Mattiplex/RAINBOW-DASH-Keyboard-/README.md

# RAINBOW-DASH-KEYBOARD-
A MLP theme KEYBOARD !!!

oh yeah , watch me take on this four day challenge to create this keyboard with no experience. (editing matthew here) so keeb got extended but i miss the deadline so im shipping to STARDANCE. oh well stardance has ended also well better luck at fabricate !!!

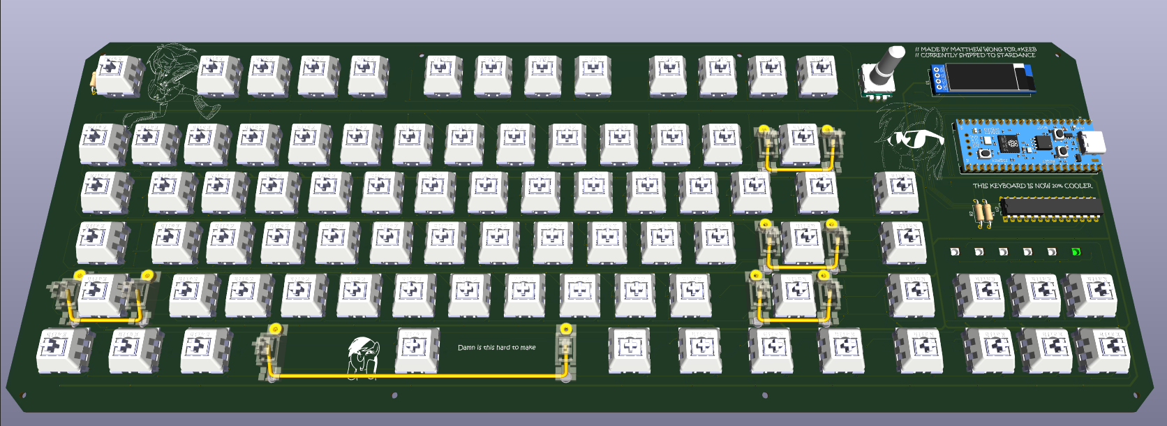
[picture p1: photo folder unlabel/Screenshot 2026-10-20 165513.png]


# The What,Why and What i learn.  
## The WHAT
RAINBOW DASH KEYBOARD is a 75% and TKL Hybrid MLP theme keyboard. this keyboard features 84 mechanical switches with hot swappable socket ,Backlit south facing RGB LED,Rotary Encoder and a 0.91 inch OLED screen.this keyboard is power by 3rd party Pico clone board with usb-c port. i also design a custom Case that uses a bottom mount system, The case will be 3d printed with FDM technology Using PETG and be painted later using spray paint. The plate will be fabricated using aluminum 6061-T6 Alloy and have an anodized blue and glass bead sanding finish.There's also a custom Knob that will be printed using PLA.

## The WHY   
so this is my first keyboard, so i decide to challenge myself to create something that's distinctly me. something that other people doesn't have and that is functional so a keyboard is fun little challenge.i want to be able look at me keyboard and be reminded of the countless night i spend making this keyboard.  

## What have i LEARN ?  
i learn lots of stuff, first of all is to do tons of research before going through something you're not familiar with. i also how to make a keyboard , how to plan your keyboard before hand so you don't mess up later in your PCB phase. (i learn all of these the hard way).
CAD is a bit harder for me because im such a perfectionist. but everything gets better with the flow of time as you gain experience. now the KEYWORD here is failing. during the whole length of this project , i fail a lot and that's how i learn ,you learn by failing and trying again.

# The PCB 

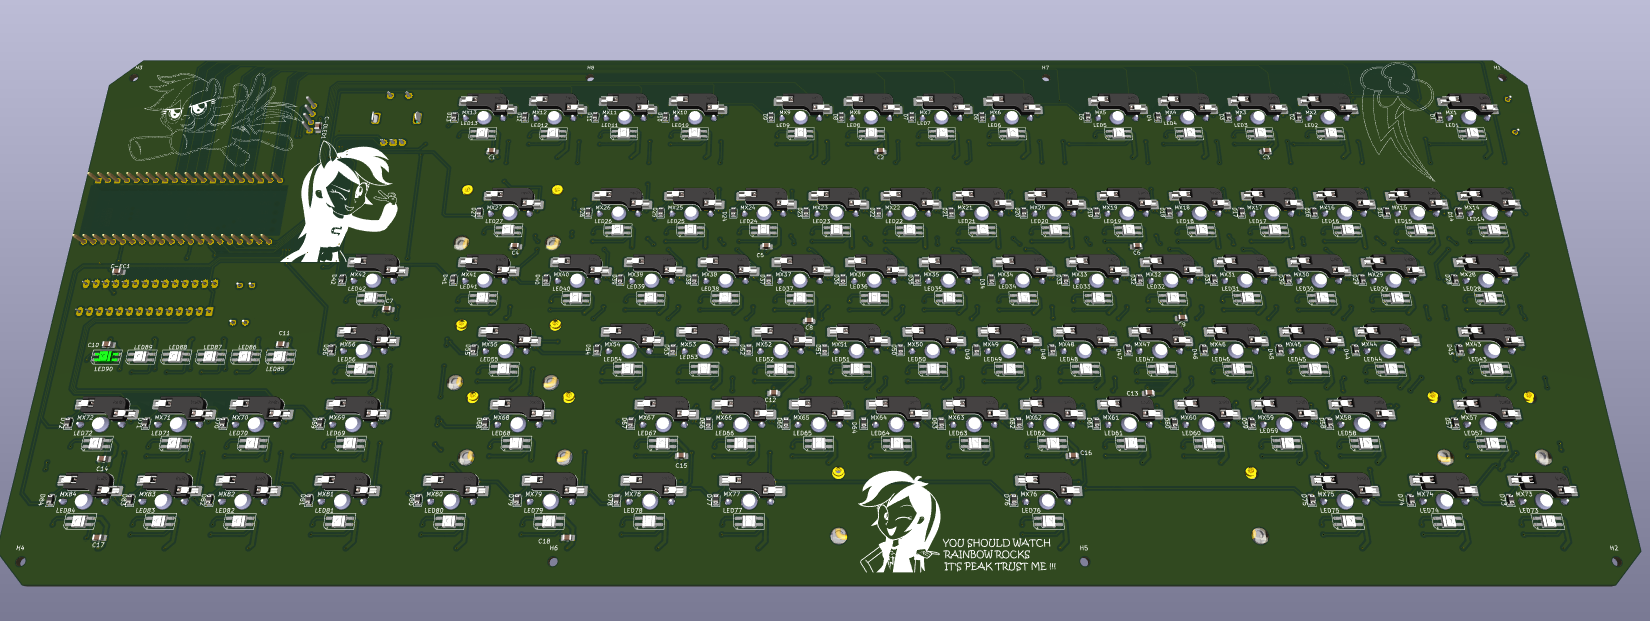
[picture p2: photo folder unlabel/Screenshot 2026-10-20 165417.png]
 

# The Case 

i used Bottom style mount to house my pcb , since i think it's the most balance layout between sound , cost and complexity . i also made the plate to integrate inside the bottom case so the plate would sit flush in the case. 
* Bottom Case: PLA WHITE
* TOP Case : PLA WHITE
* KEYBOARD PLATE : Laser Cut Aluminum (anodized blue + bead blast)
* CUSTOM Knob : PLA WHITE

# README
3D PRINTING : PRINTING LEGION @raahicheda4 (SG)

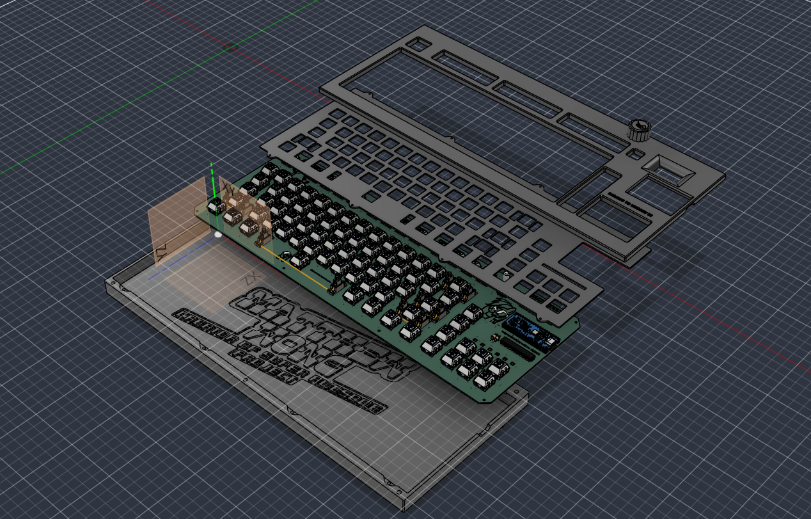
[picture p3: photo folder unlabel/Screenshot 2026-10-20 002253.png]
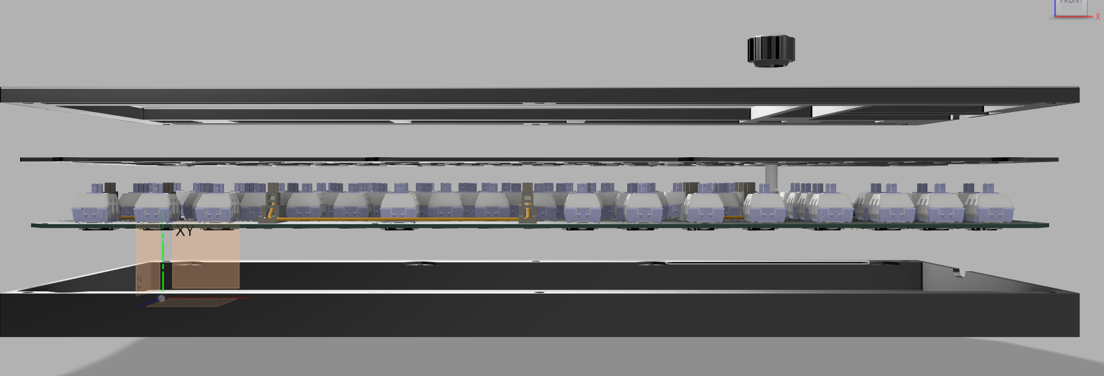
[picture p4: photo folder unlabel/Screenshot 2026-10-20 003000.png]
 

# ASSEMBLY Video

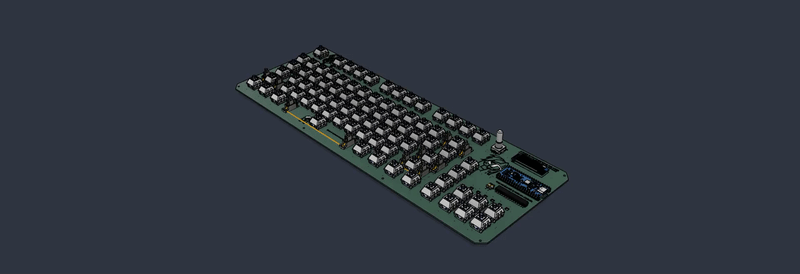
[picture p5: photo folder unlabel/rainbowdashkeyboardassembly-ezgif.com-gif-to-apng-converter.png]


# Time   

  | no | desc | Time taken |  
  | -- | ---- | -----------|  
  | 1. | first design session | 14Hour 33Min 58 Sec |   
  | 2. | second design session | 22Hour 17Min 35Sec |  
  | 3. | CAD design session | 24Hour 27Min 46Sec |  
  | 4. | prepping model and inspection | 39Min |
  | - | total time | 62Hour 12Min 58Sec | 

# price 

| No | DESC | USD | 
| -- | ---- | --- |
| 1. | PCB Board (5 piece)| 21.23USD | 
| 1. | 0805 SMD Cap (20 Piece) ELEMENT14 | 6.02$ | 
| 2. | Kalih Hot Swappable socket (110pc) | 6.06$ |
| 3. | 330R resistor 100pc | 1.12$ |
| 4. | 4700R resistor 100pc | 2.45$ |
| 5. | MCP23017 DIP28 2pc | 6.02$ |
| 6. | EC11 Rotary Encoder 1pc | 0.73$ |
| 7. | M2 Heatset Insert L 3mm 50pc  | 1.41$ |
| 8. | M3 Heatset Insert L 3mm 50pc  | 1.47$ |
| 9. | HZYUEGOU M2 hex wafer head screw  5mm 50pc  | 0.94$ |
| 10. | HZUEGOU M3 hex Wafer head screw 20mm 25pc  |  1.11$ |
| 11. | 1N4148 0805 SOD-323 diode 100pc |  0.95$ |
| 12. | SK6812 MINi-E RGB reverse mount 100pc | 5.71$ |
| 13. | Third party Pi-Pico with Usb-c 1pc | 2.57$ |
| 14. | 0.91inch OLED SCREEN 1pc  | 2.36$ |
| 15. | 1mm transparent acrylic sheet 1 pc | 0.92$ |
| 1. | Jaycomia Rainbow PBT Keycaps Set | 20.37$ |
| 2. | Kalih Box Jade Tactile switch (90pc) | 20.49$ |
| 3. | Durock Stabilizer V3 set 4(2u) 1(6.25u) | 18.26$ |
| 4. | Fancy rainbow coiled Usb-C cable with aviator connector | 7.97$ |
| 3. | Shipping Fee (ALIEXPRESS) | 1.58$ |
| 4. | Shipping Fee (ELEMENT14) | None |
| 5. | TAX (ALIEXPRESS) | 10.93$ | 
| 6. | Extra 5$ for daily price fluctuation Aliexpress | 5$ | 
| 1. | Top Case,bottom case & custom knob (Printing Legion) | 30$ |
| 2. | aluminum Plate (PCBWAY) | 39.77$ | 
| 3. | shipping Fee (Printing Legion) | 10$ |
| 4. | shipping Fee (PCBWAY) | none (air freight) | 
| - | Total | 225.44$ | 

## excluded stuff (coz it's expensive enough alr)
* spray paint & primer 
* high grit sand paper 
* solder and flux
