Mattiplex/RAINBOW-DASH-Keyboard-/Assembly file/Electronics needed (exact).md

## PCB 
| No | DESC | Quantity |
| -- | ---- | --- |
| 1 | PCB Board | 1pc |

## Solder on component  
| No | DESC | quantity |
| -- | ---- | --- |
| 1. | 0805 SMD 100nf capacitor| 20pc |  
| 2. | Kalih Hot Swappable socket | 84pc | 
| 3. | 330R resistor | 1pc | 
| 4. | 4700R resistor | 2pc | 
| 5. | MCP23017 DIP28  | 1pc | 
| 6. | EC11 Rotary Encoder 20mm shaft| 1pc| 
| 7. | M2 Heatset Insert L 3mm | 8pc | 
| 8. | M3 Heatset Insert L 3mm | 6pc | 
| 9. | HZYUEGOU M2 hex wafer head screw  5mm | 8pc | 
| 10. | HZUEGOU M3 hex Wafer head screw 20mm | 6pc |  
| 11. | 1N4148 0805 SOD-323 diode | 84pc |  
| 12. | SK6812 MINi-E RGB reverse mount | 90pc | 
| 13. | Third party Pi-Pico with Usb-c | 1pc |
| 14. | 0.91inch OLED SCREEN | 1pc | 
| 15. | 1mm transparent acrylic sheet 150*200mm | 1pc |

## ACCESSORY (ALIEXPRESS)
| No | DESC | quantity |
| -- | ---- | --- |
| 1. | Jaycomia Rainbow PBT Keycaps Set | 1set(110pc) |
| 2. | Kalih Box Jade Tactile switch | 84pc | 
| 3. | Durock Stabilizer V3 set 4(2u) 1(6.25u) | 1 set |
| 4. | Fancy rainbow coiled Usb-C cable with aviator connector | 1pc |
