Mattiplex/RAINBOW-DASH-Keyboard-/List of Bill/Aliexpress Bundle.png

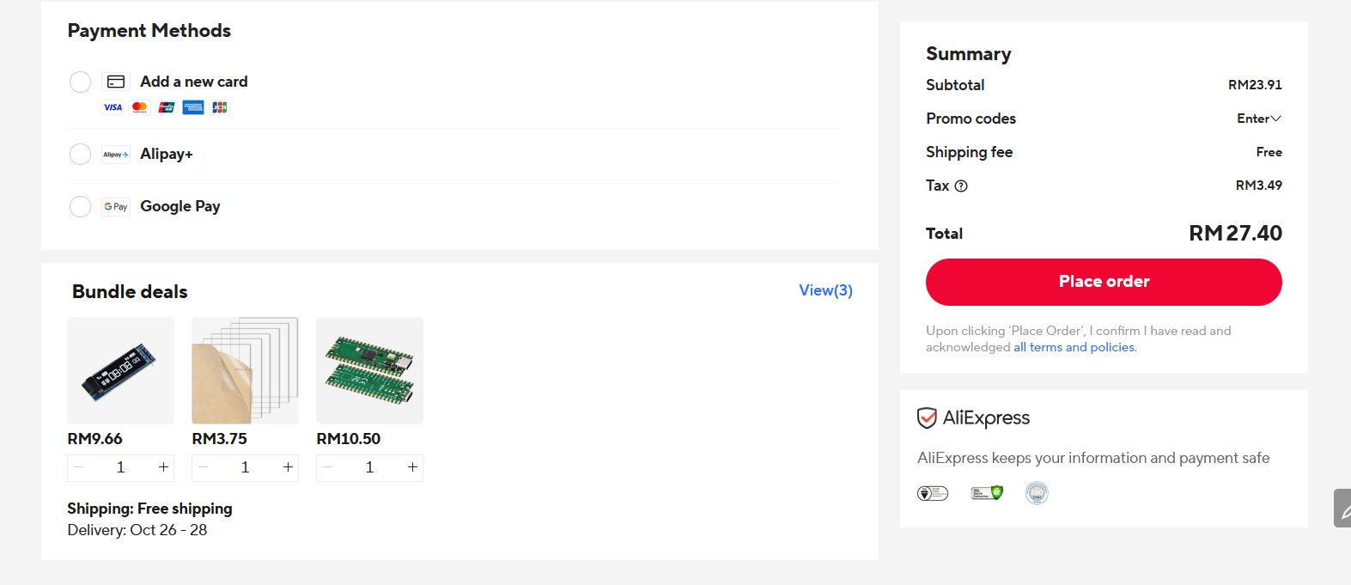
List of Bill/Aliexpress Bundle.png
