Mattiplex/RAINBOW-DASH-Keyboard-/List of Bill/Aliexpress.png

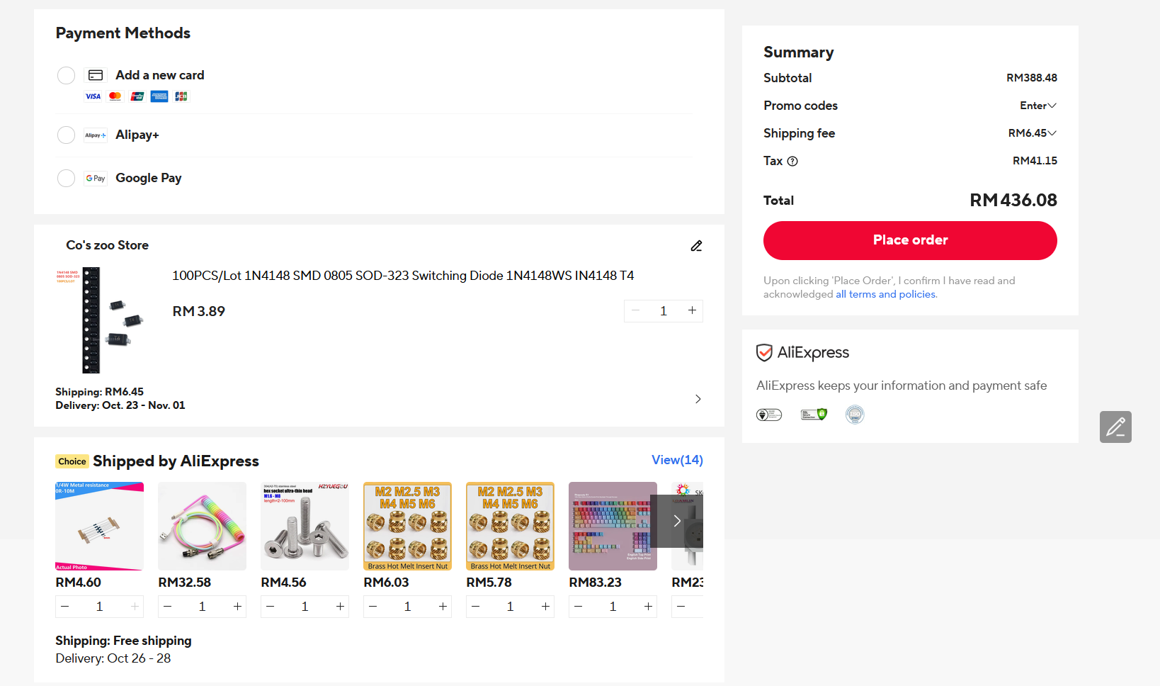
List of Bill/Aliexpress.png
