Mattiplex/RAINBOW-DASH-Keyboard-/List of Bill/Aluminum Plate.png

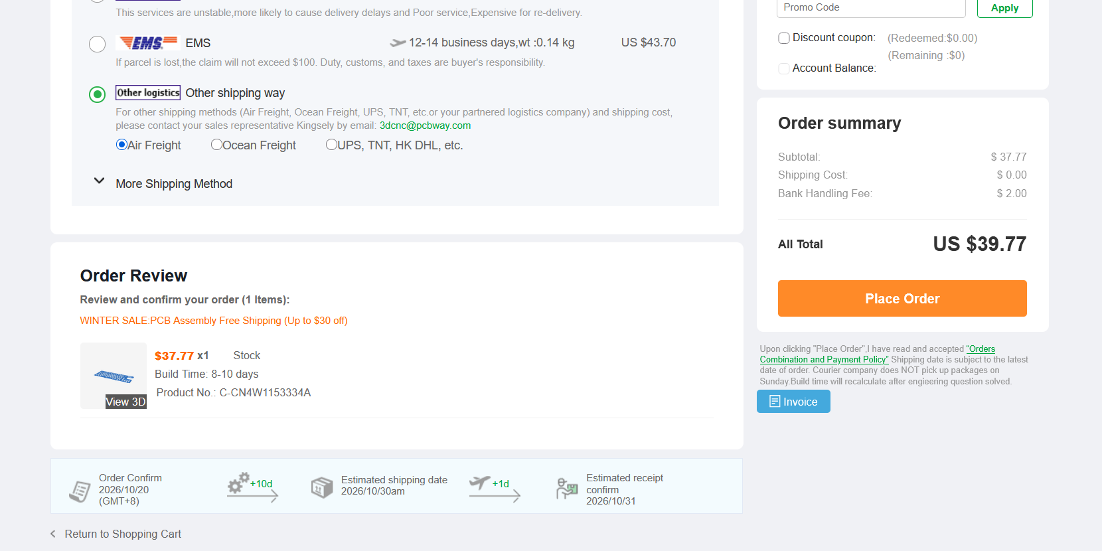
List of Bill/Aluminum Plate.png
