Mattiplex/RAINBOW-DASH-Keyboard-/List of Bill/Element 14.png

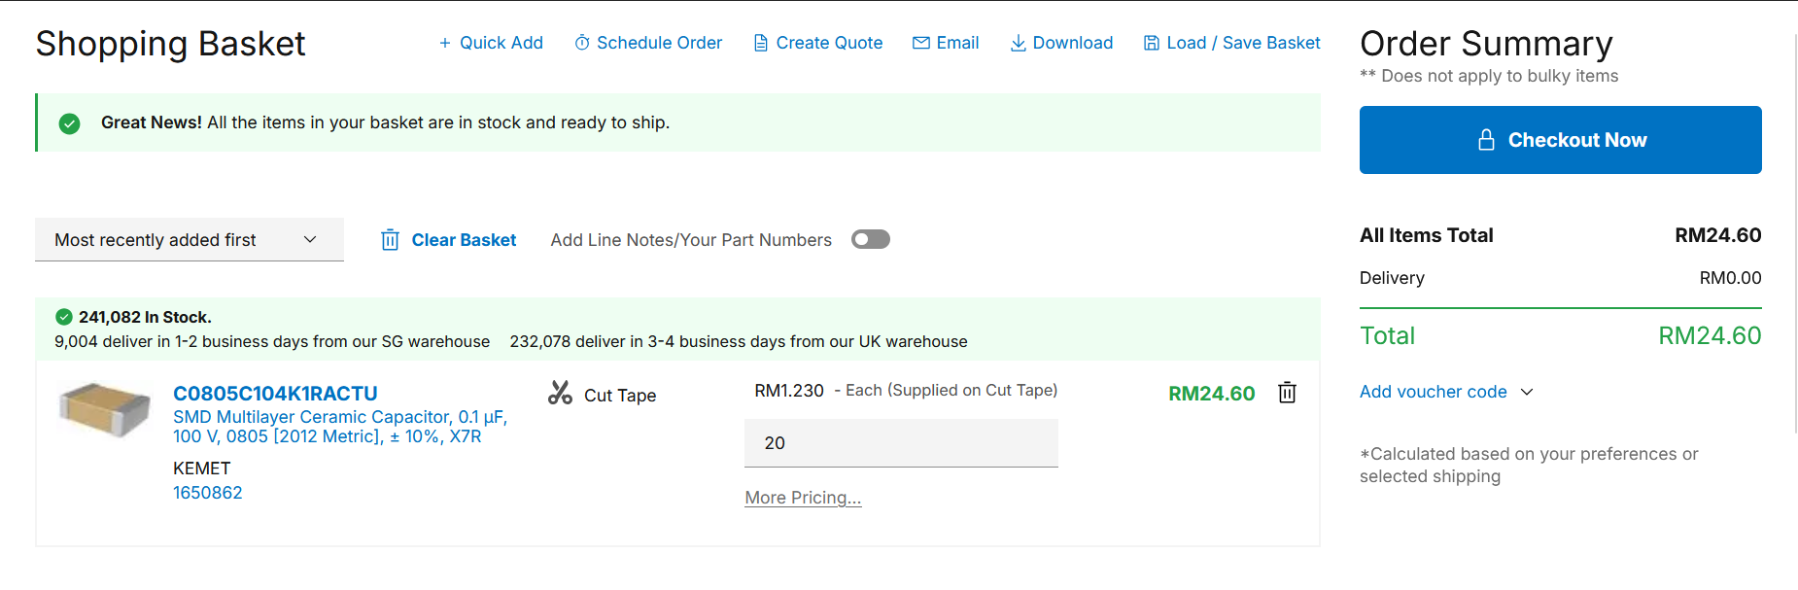
List of Bill/Element 14.png
