Mattiplex/RAINBOW-DASH-Keyboard-/List of Bill/PCB Price.png

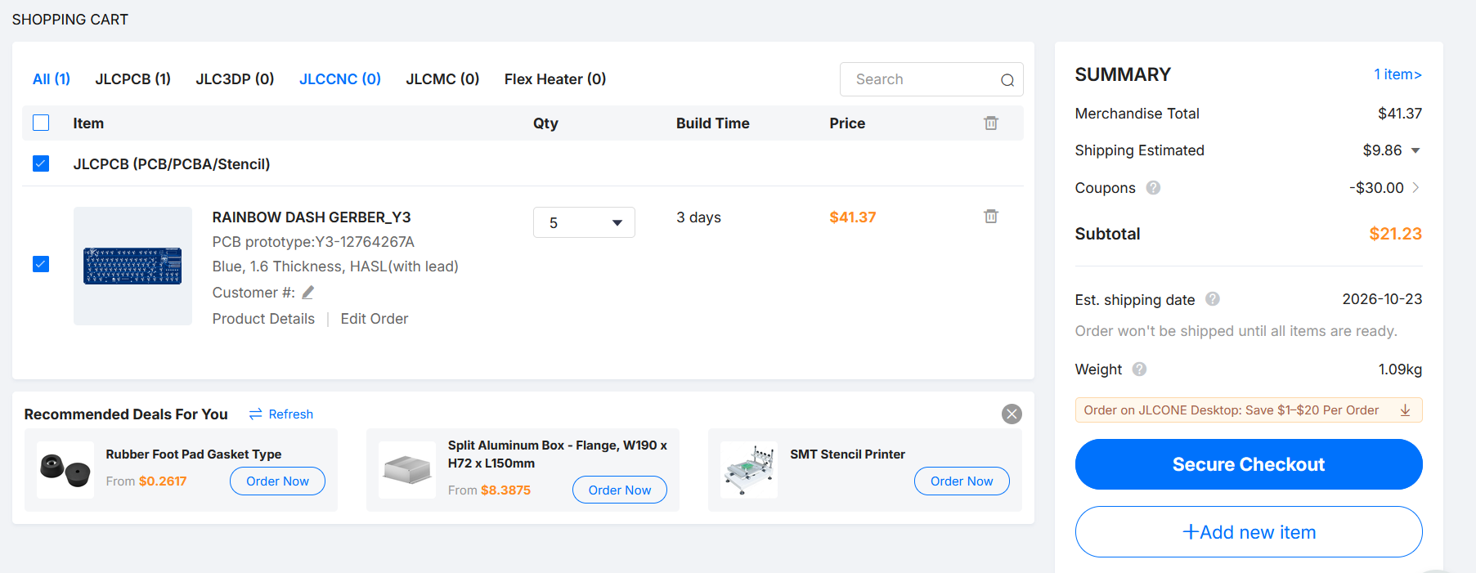
List of Bill/PCB Price.png
