Mattiplex/RAINBOW-DASH-Keyboard-/photo folder label/8. 75% done.png

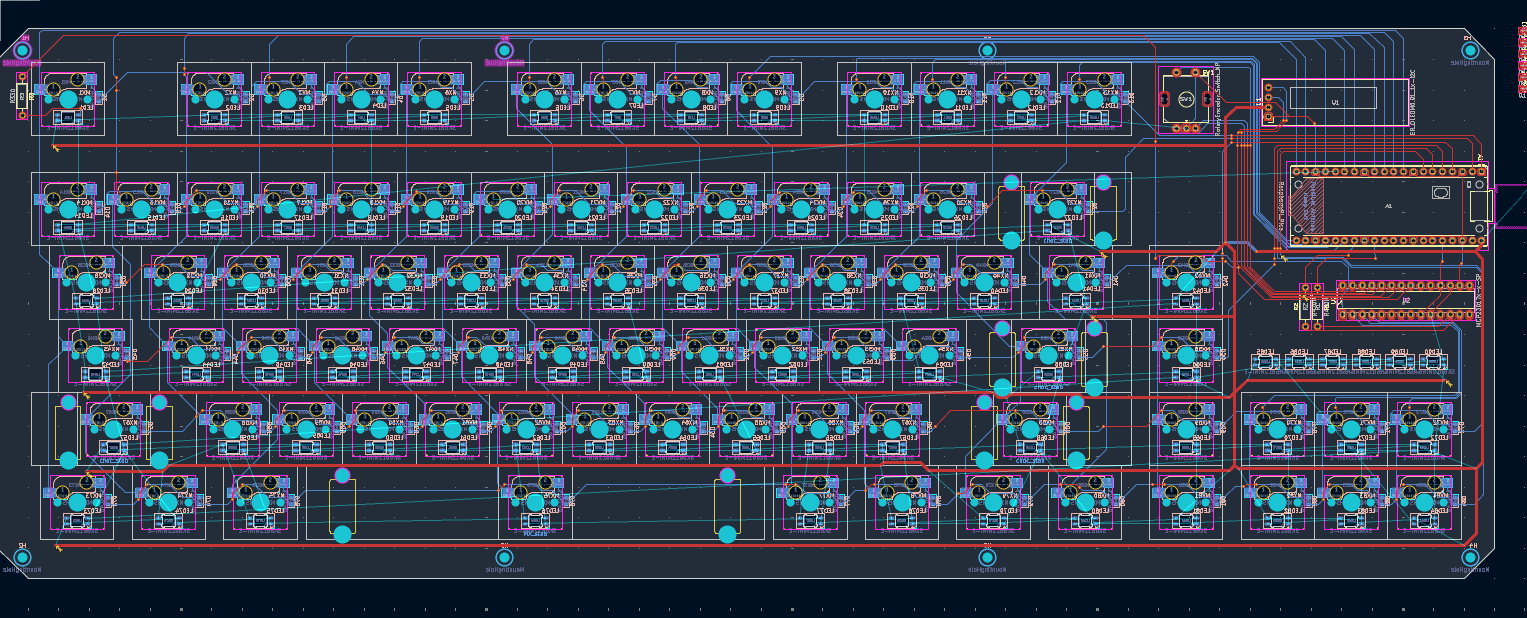
photo folder label/8. 75% done.png
