Mattiplex/RAINBOW-DASH-Keyboard-/keyboard bom 1.csv

Item Name | quantity | price total (USD) | item link | note
0805 SMD Capacitor Element14 | 20 piece | $6.02 | https://my.element14.com/kemet/c0805c104k1ractu/cap-0-1-f-100v-10-x7r-0805/dp/1650862
Kalih Hot Swappable socket | 110 piece | $6.06 | https://www.aliexpress.com/item/1005007232040760.html?mp=1
330R resistor | 100 piece | $1.12 | https://www.aliexpress.com/item/1005006848644172.html?mp=1
4700R resistor | 100 piece | $2.45 | https://www.aliexpress.com/item/1005006848644172.html?mp=1
MCP23017 DIP28 | 2 piece | $6.02 | https://www.aliexpress.com/item/1005008686069126.html?mp=1
EC11 Rotary Encoder | 1 piece | $0.73 | https://www.aliexpress.com/item/1005007644083514.html
M2 Heatset Insert L 3mm | 50 piece | $1.41 | https://www.aliexpress.com/item/1005003582355741.html?mp=1
M3 Heatset Insert L 3mm | 50 piece | $1.47 | https://www.aliexpress.com/item/1005003582355741.html?mp=1
HZYUEGOU M2 hex wafer head screw 5mm | 50piece | $0.94 | https://www.aliexpress.com/item/4001072025844.html?mp=1
HZUEGOU M3 hex Wafer head screw 20mm | 25 piece | $1.11 | https://www.aliexpress.com/item/4001072025844.html?mp=1
1N4148 0805 SOD-323 diode | 100 piece | $0.95 | https://www.aliexpress.com/item/1005002340232205.html
SK6812 MINi-E RGB reverse mount | 100 piece | $5.71 | https://www.aliexpress.com/item/1005005193716172.html?mp=1
Third party Pi-Pico with Usb-c | 1 piece | $2.57 | https://www.aliexpress.com/ssr/300000512/BundleDeals2?productIds=1005007010063057:12000039048148140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 | this is a dummy link refer to list of bill or picture in cart screen shot
0.91inch OLED SCREEN | 1 piece | $2.36 | https://www.aliexpress.com/ssr/300000512/BundleDeals2?productIds=1005007010063057:12000039048148140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 | this is a dummy link refer to list of bill or picture in cart screen shot
1mm transparent acrylic sheet | 1 piece | $0.92 | https://www.aliexpress.com/ssr/300000512/BundleDeals2?productIds=1005007010063057:12000039048148140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 | this is a dummy link refer to list of bill or picture in cart screen shot
Jaycomia Rainbow PBT Keycaps Set | 1 set | $20.37 | https://www.aliexpress.com/item/1005010053649706.html?mp=1
Kalih Box Jade Tactile switch (90pc) | 90 piece | $20.49 | https://www.aliexpress.com/item/1005011779491318.html?mp=1
Durock Stabilizer V3 set 4(2u) 1(6.25u) | 1 set | $18.26 | https://www.aliexpress.com/item/1005004678734403.html?mp=1
Fancy rainbow coiled Usb-C cable with aviator connector | 1 piece | $7.97 | https://www.aliexpress.com/item/1005006166034508.html?mp=1
PCB Board | 5 board | $21.23 | https://cart.jlcpcb.com/shopcart/cart | this is a dummy link refer to list of bill or picture in cart screen shot
Shipping Fee (ALIEXPRESS) | all items | $1.58 | https://www.aliexpress.com/?spm=a2g0o.productlist.logo.1.d3ac56f7kuih3L | this is a dummy link refer to list of bill or picture in cart screen shot
Shipping Fee (ELEMENT14) | all items | None | https://my.element14.com/cart | this is a dummy link refer to list of bill or picture in cart screen shot
TAX (ALIEXPRESS) | all items | $10.93 | https://www.aliexpress.com/?spm=a2g0o.productlist.logo.1.d3ac56f7kuih3L | this is a dummy link refer to list of bill or picture in cart screen shot
Extra 5$ for daily price fluctuation Aliexpress | - | $5.00 | https://www.aliexpress.com/?spm=a2g0o.productlist.logo.1.d3ac56f7kuih3L | this is a dummy link
Top case & bottom case & custom knob (Printing Legion) | 3 piece | $30.00 | https://hackclub.slack.com/archives/C083P4FJM46/p1792146024675589
aluminum Plate (PCBWAY) | 1 piece | $39.77 | https://member.pcbway.com/order/cartlist | this is a dummy link refer to list of bill or picture in cart screen shot
shipping Fee (Printing legion) Singapore → Malaysia | 3 piece | $10.00 | https://hackclub.slack.com/archives/C083P4FJM46/p1792146024675589
shipping Fee (PCBWAY) | 1 piece | none (air freight) | https://member.pcbway.com/order/cartlist | this is a dummy link refer to list of bill or picture in cart screen shot
 |  | $225.44
