Mattiplex/RAINBOW-DASH-Keyboard-/keyboard bom.csv-Sheet1.csv

PCB | JLCPCB | - | -
No | Desc | Quantity | MYR | USD | item link
1 | PCB Board | 5 | - | $21.23 | refer to list of bill
 | Solder on Components, ALIEXPRESS & ELEMENT14
No | Desc | quantity | MYR | USD | item link
1 | 0805 SMD Cap ELEMENT14 | 20 piece | RM24.60 | $6.02 | https://my.element14.com/kemet/c0805c104k1ractu/cap-0-1-f-100v-10-x7r-0805/dp/1650862
2 | Kalih Hot Swappable socket | 110 piece | RM24.75 | $6.06 | https://www.aliexpress.com/item/1005007232040760.html?mp=1
3 | 330R resistor | 100 piece | RM4.59 | $1.12 | https://www.aliexpress.com/item/1005006848644172.html?mp=1
4 | 4700R resistor | 100 piece | RM10 | $2.45 | https://www.aliexpress.com/item/1005006848644172.html?mp=1
5 | MCP23017 DIP28 | 2 piece | RM24.56 | $6.02 | https://www.aliexpress.com/item/1005008686069126.html?mp=1
6 | EC11 Rotary Encoder | 1 piece | RM2.98 | $0.73 | https://www.aliexpress.com/item/1005007644083514.html
7 | M2 Heatset Insert L 3mm | 50 piece | RM5.77 | $1.41 | https://www.aliexpress.com/item/1005003582355741.html?mp=1
8 | M3 Heatset Insert L 3mm | 50 piece | RM6.02 | $1.47 | https://www.aliexpress.com/item/1005003582355741.html?mp=1
9 | HZYUEGOU M2 hex wafer head screw 5mm | 50piece | RM3.83 | $0.94 | https://www.aliexpress.com/item/4001072025844.html?mp=1
10 | HZUEGOU M3 hex Wafer head screw 20mm | 25 piece | Rm4.55 | $1.11 | https://www.aliexpress.com/item/4001072025844.html?mp=1
11 | 1N4148 0805 SOD-323 diode | 100 piece | RM3.88 | $0.95 | https://www.aliexpress.com/item/1005002340232205.html
12 | SK6812 MINi-E RGB reverse mount | 100 piece | RM23.33 | $5.71 | https://www.aliexpress.com/item/1005005193716172.html?mp=1
13 | Third party Pi-Pico with Usb-c | 1 piece | Rm10.49 | $2.57 | Bundle deal I can’t show the exact item cuz when I try it just show the bundle deals page
14 | 0.91inch OLED SCREEN | 1 piece | RM9.65 | $2.36 | Bundle deal I can’t show the exact item cuz when I try it just show the bundle deals page
15 | 1mm transparent acrylic sheet | 1 piece | RM3.75 | $0.92 | Bundle deal I can’t show the exact item cuz when I try it just show the bundle deals page
- | total | - | RM177.52 | $43.48
 | ACCESSORY ALIEXPRESS
No | Desc | quantity | MYR | USD
1 | Jaycomia Rainbow PBT Keycaps Set | 1 set | RM83.15 | $20.37 | https://www.aliexpress.com/item/1005010053649706.html?mp=1
2 | Kalih Box Jade Tactile switch (90pc) | 90 piece | RM83.63 | $20.49 | https://www.aliexpress.com/item/1005011779491318.html?mp=1
3 | Durock Stabilizer V3 set 4(2u) 1(6.25u) | 1 set | RM74.55 | $18.26 | https://www.aliexpress.com/item/1005004678734403.html?mp=1
4 | Fancy rainbow coiled Usb-C cable with aviator connector | 1 piece | RM32.52 | $7.97 | https://www.aliexpress.com/item/1005006166034508.html?mp=1
- | total |  | RM273.85 | $67.09
 | TOTAL ALIEXPRESS & ELEMENT14
No | Desc | quantity | MYR | USD
1 | Solder On Components | 15 items | RM177.52 | $43.48
2 | ACCESSORY | 4 items | RM273.85 | $67.09
3 | Shipping Fee (ALIEXPRESS) | all items | RM6.45 | $1.58
4 | Shipping Fee (ELEMENT14) | all items | None | None
5 | TAX (ALIEXPRESS) | all items | RM44.64 | $10.93
6 | Extra 5$ for daily price fluctuation Aliexpress | - | RM20.41 | $5.00
- | Total | - | RM522.87 | $128.08
 | Case (PCBWAY & Printing Legion)
No | Desc | quantity | MYR | USD | item link
1 | Top case & bottom case & custom knob (Printing Legion) | 3 piece | - | $30.00 | https://hackclub.slack.com/archives/C083P4FJM46/p1792146024675589
2 | aluminum Plate (PCBWAY) | 1 piece | - | $39.77 | refer to list of bill
3 | shipping Fee (Printing legion) Singapore → Malaysia | 3 items | - | $10.00 | https://hackclub.slack.com/archives/C083P4FJM46/p1792146024675589
4 | shipping Fee (PCBWAY) | 1 items | - | none (air freight) | refer to list of bill
 | Total | - | - | $79.77
 | total price
 | PCB(21.23$) + Component&Accssory(128.08$)
 | + CASE(79.77$) = 229.08$
 | Page 3
Sheet1
Page 4
Sheet1
Page 5
Sheet1
Page 6
Sheet1
Page 7
Sheet1
Page 8
Sheet1
Page 9
