Mattiplex/RAINBOW-DASH-Keyboard-/Production file/BOM RAINBOW DASH.csv

Id | Designator | Footprint | Quantity | Designation | Supplier and ref
1 | A1 | RaspberryPi_Pico_Common_THT | 1 | RaspberryPi_Pico
2 | backspace1 | STAB_MX_2u | 1 | choc_stab
3 | C-EC1, C-OLED1, C1, C2, C3, C4, C5, C6, C7, C8, C9, C10, C11, C12, C13, C14, C15, C16, C17, C18 | C_0805_2012Metric_Pad1.18x1.45mm_HandSolder | 20 | 0.1uf
4 | D1, D2, D3, D4, D5, D6, D7, D8, D9, D10, D11, D12, D13, D14, D15, D16, D17, D18, D19, D20, D21, D22, D23, D24, D25, D26, D27, D28, D29, D30, D31, D32, D33, D34, D35, D36, D37, D38, D39, D40, D41, D42, D43, D44, D45, D46, D47, D48, D49, D50, D51, D52, D53, D54, D55, D56, D57, D58, D59, D60, D61, D62, D63, D64, D65, D66, D67, D68, D69, D70, D71, D72, D73, D74, D75, D76, D77, D78, D79, D80, D81, D82, D83, D84 | D_0805_2012Metric | 84 | 1N4148
5 | enter1, left-shift1 | STAB_MX_2.25u | 2 | choc_stab
6 | LED1, LED2, LED3, LED4, LED5, LED6, LED7, LED8, LED9, LED10, LED11, LED12, LED13, LED14, LED15, LED16, LED17, LED18, LED19, LED20, LED21, LED22, LED23, LED24, LED25, LED26, LED27, LED28, LED29, LED30, LED31, LED32, LED33, LED34, LED35, LED36, LED37, LED38, LED39, LED40, LED41, LED42, LED43, LED44, LED45, LED46, LED47, LED48, LED49, LED50, LED51, LED52, LED53, LED54, LED55, LED56, LED57, LED58, LED59, LED60, LED61, LED62, LED63, LED64, LED65, LED66, LED67, LED68, LED69, LED70, LED71, LED72, LED73, LED74, LED75, LED76, LED77, LED78, LED79, LED80, LED81, LED82, LED83, LED84, LED85, LED86, LED87, LED88, LED89, LED90 | LED_SK6812MINI-E_3.2x2.8mm_P1.5mm_ReverseMount | 90 | SK6812MINI-E
7 | MX1, MX2, MX3, MX4, MX5, MX6, MX7, MX8, MX9, MX10, MX11, MX12, MX13, MX14, MX15, MX16, MX17, MX18, MX19, MX20, MX21, MX22, MX23, MX24, MX25, MX26, MX27, MX28, MX29, MX30, MX31, MX32, MX33, MX34, MX35, MX36, MX37, MX38, MX39, MX40, MX41, MX42, MX43, MX44, MX45, MX46, MX47, MX48, MX49, MX50, MX51, MX52, MX53, MX54, MX55, MX56, MX57, MX58, MX59, MX60, MX61, MX62, MX63, MX64, MX65, MX66, MX67, MX68, MX69, MX70, MX71, MX72, MX73, MX74, MX75, MX76, MX77, MX78, MX79, MX80, MX81, MX82, MX83, MX84 | SW_MX_HS_CPG151101S11_1u | 84 | MX_SW_HS
8 | R1, R2 | R_Axial_DIN0207_L6.3mm_D2.5mm_P10.16mm_Horizontal | 2 | R4700
9 | R3 | R_Axial_DIN0207_L6.3mm_D2.5mm_P10.16mm_Horizontal | 1 | R330
10 | right-shift1 | STAB_MX_2.75u | 1 | choc_stab
11 | spacebar1 | STAB_MX_6.25u | 1 | MX_stab
12 | SW1 | ROT_Alps_EC11E-Switch | 1 | RotaryEncoder_Switch_MP
13 | U1 | ER_OLEDM0.91_1x-I2C | 1 | ER_OLEDM0.91_1x-I2C
14 | U2 | DIP-28_W7.62mm_LongPads | 1 | MCP23017x-x-SP
