Mattiplex/RAINBOW-DASH-Keyboard-/pictures in descending order = date/14. started on the case.png

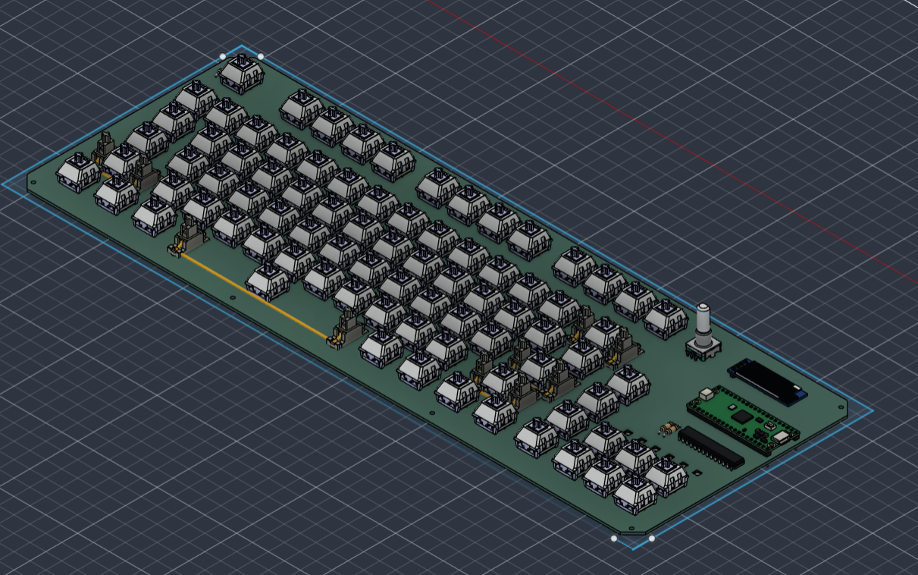
pictures in descending order = date/14. started on the case.png
