Mattiplex/RAINBOW-DASH-Keyboard-/Production file/custom knob.step

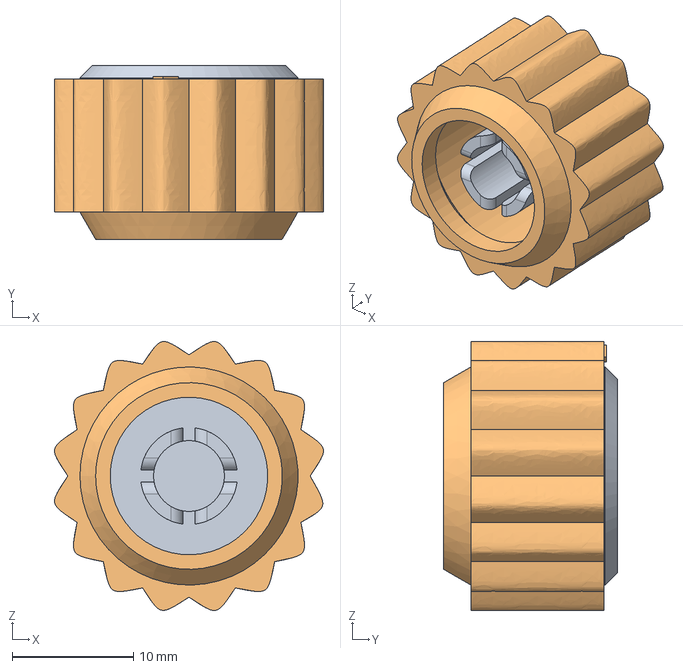
[picture p47: CAD file, 2026-11-09]
Production file/custom knob.step
22.2 x 14.3 x 22.2 mm
