Mattiplex/RAINBOW-DASH-Keyboard-/Production file/top case_Component_Left.step

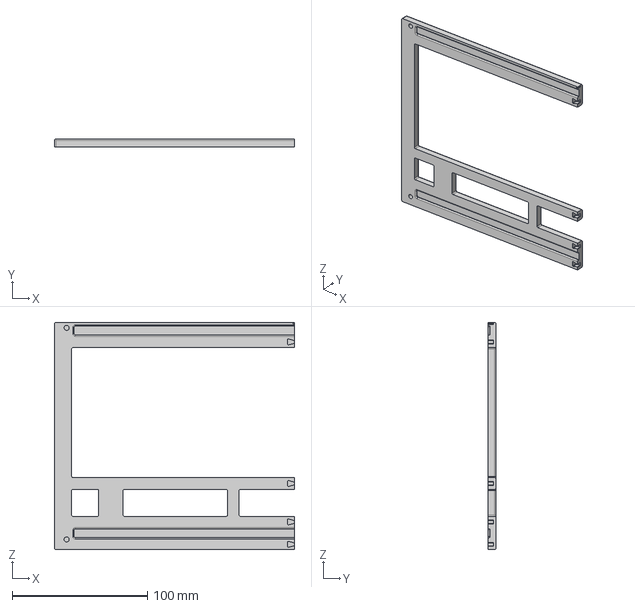
[picture p48: CAD file, 2026-11-09]
Production file/top case_Component_Left.step
177.5 x 6.00 x 168.0 mm
