Mattiplex/RAINBOW-DASH-Keyboard-/Production file/top case_Component_Right.step

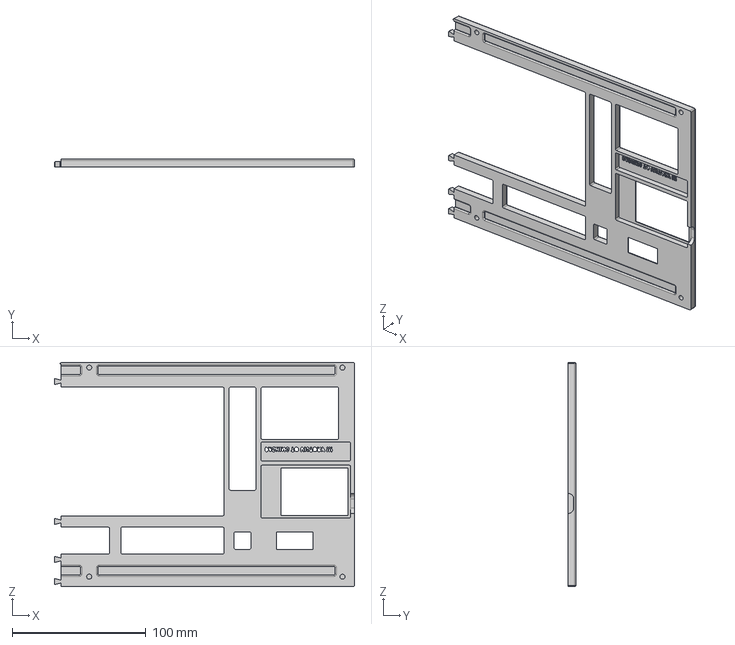
[picture p49: CAD file, 2026-11-09]
Production file/top case_Component_Right.step
224.5 x 6.00 x 168.0 mm
