Mattiplex/RAINBOW-DASH-Keyboard-/Production file/bottom case_Component_Left.step

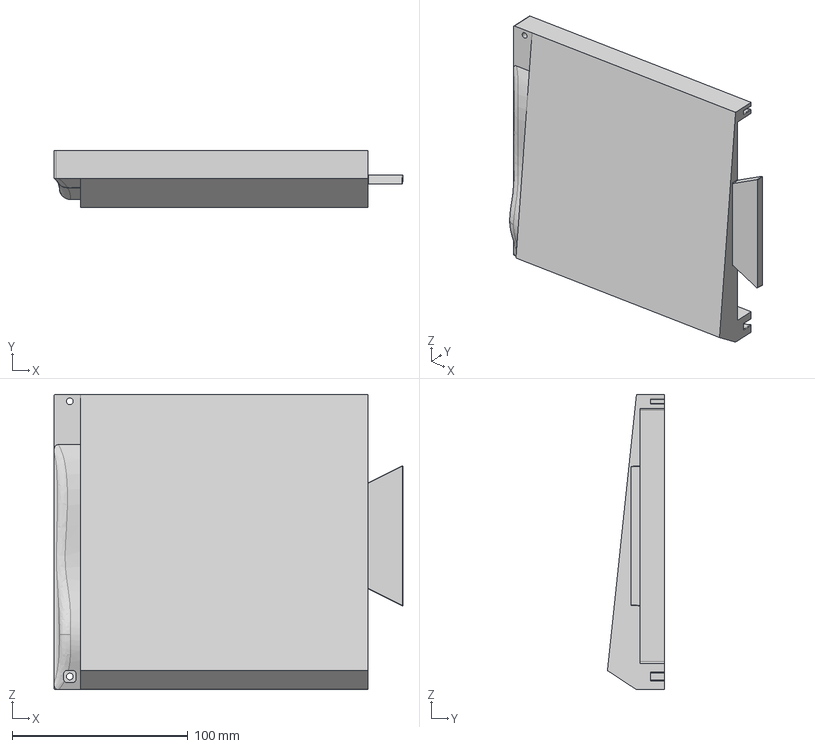
[picture p50: CAD file, 2026-11-09]
Production file/bottom case_Component_Left.step
198.5 x 32.5 x 168.0 mm
