Mattiplex/RAINBOW-DASH-Keyboard-/Production file/bottom case_Component_Middle.step

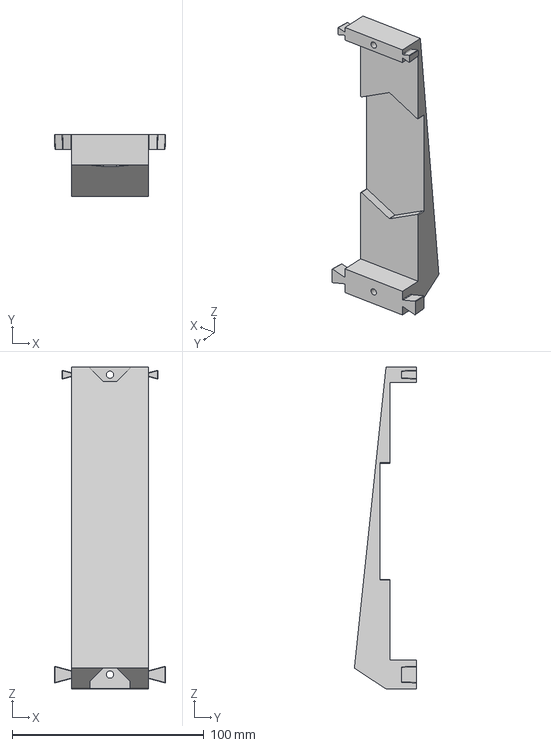
[picture p51: CAD file, 2026-11-09]
Production file/bottom case_Component_Middle.step
58.0 x 32.5 x 168.0 mm
