Mattiplex/RAINBOW-DASH-Keyboard-/Production file/bottom case.step

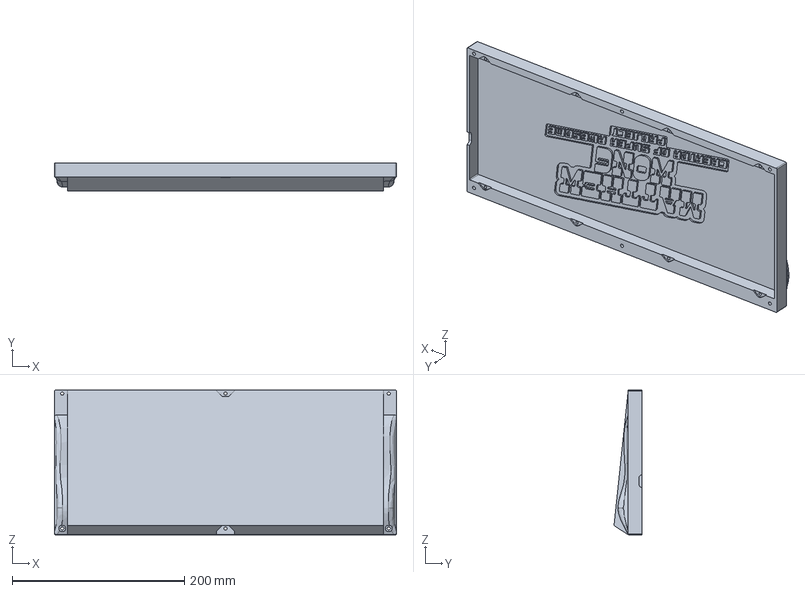
[picture p52: CAD file, 2026-10-19]
Production file/bottom case.step
397.0 x 32.5 x 168.0 mm
