Mattiplex/RAINBOW-DASH-Keyboard-/Production file/RAINBOW PLATE.step

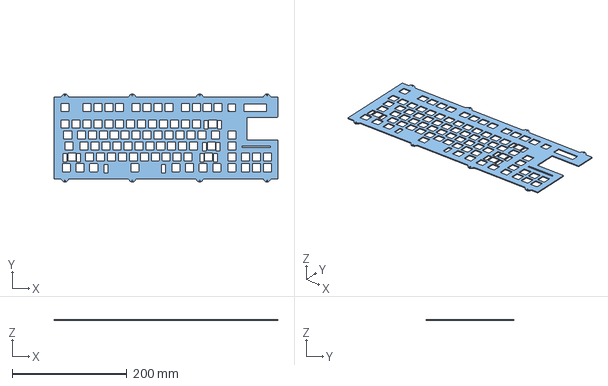
[picture p53: CAD file, 2026-10-16]
Production file/RAINBOW PLATE.step
390.0 x 154.0 x 1.50 mm
