Mattiplex/RAINBOW-DASH-Keyboard-/Production file/top case.step

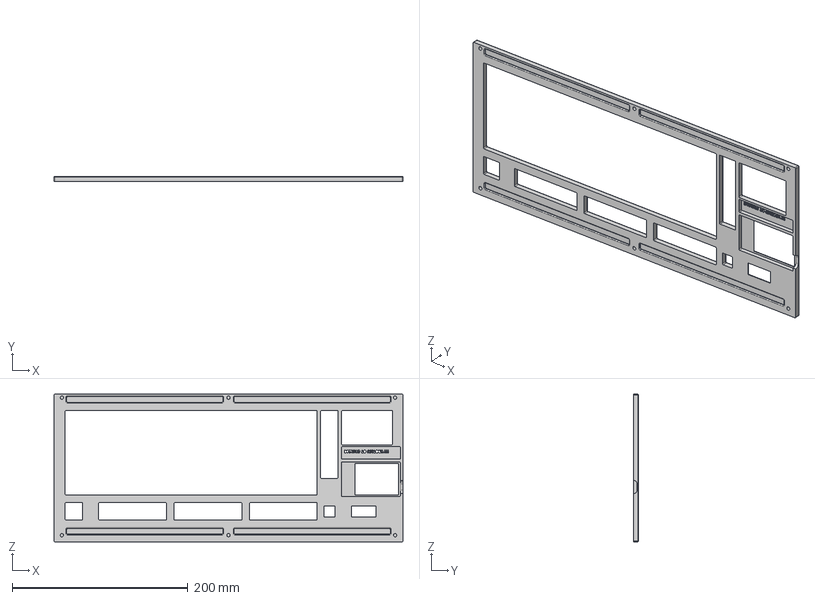
[picture p54: CAD file, 2026-10-16]
Production file/top case.step
397.0 x 6.00 x 168.0 mm
