Mattiplex/RAINBOW-DASH-Keyboard-/(list of files, cad)

Other CAD files:
Production file/bottom case_Component_Right.step
CAD file/RAINBOW PLATE.f3d
CAD file/bottom case.f3d
CAD file/custom knob.f3d
CAD file/top case.f3d
Production file/custom knob.f3d
Production file/top case.f3d
RAINBOW PLATE.f3d
bottom case.f3d
