Mattiplex/RAINBOW-DASH-Keyboard-/List of Bill/3D Printing (2).png

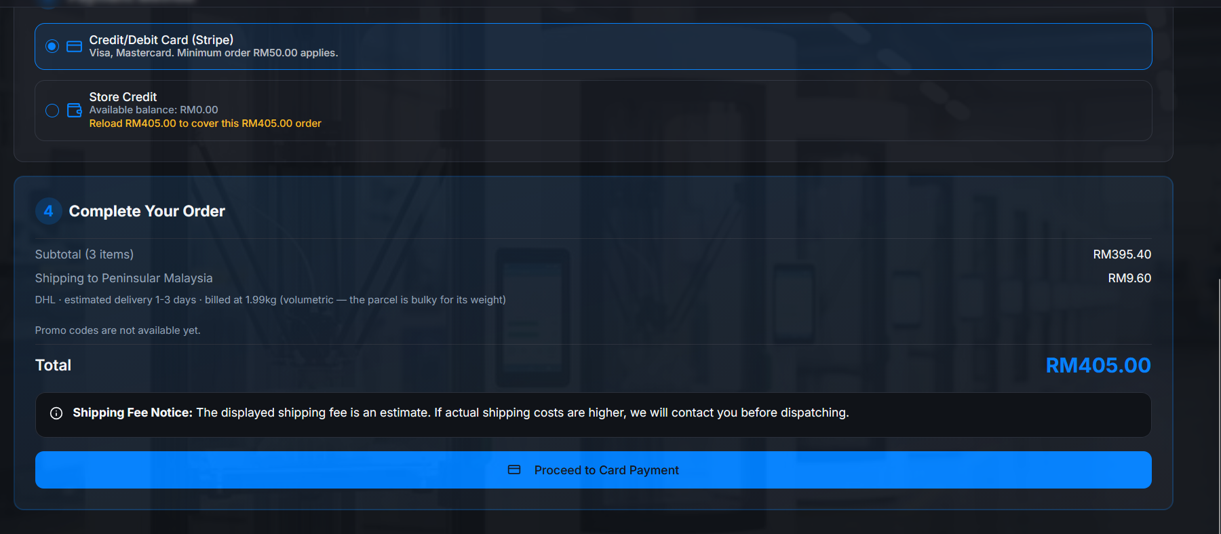
List of Bill/3D Printing (2).png
