Mattiplex/RAINBOW-DASH-Keyboard-/List of Bill/3D Printing.png

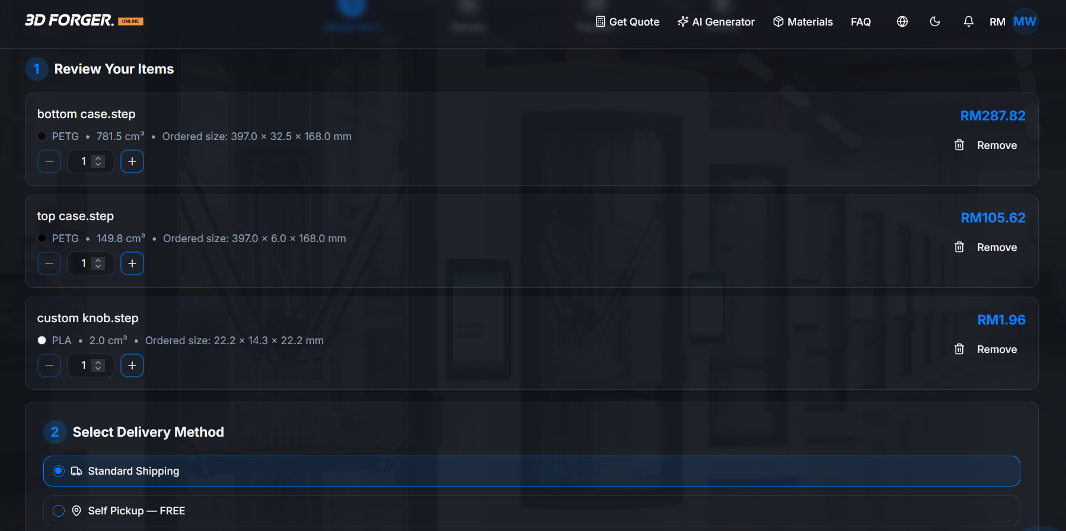
List of Bill/3D Printing.png
