Mattiplex/RAINBOW-DASH-Keyboard-/JOURNAL.md

# Project Timeline 
this file is going to be all text pictures will be in the two file

## Day 1  
early sketch of my keyboard added
9 hours later, free again
i made the schematics for my keyboard thou it's still missing two functions  
(editing matthew here) don't add one cap for each led it's overkill

 

## Day 2  
finished wiring up my schematics , added a mcp23008 extension chip, rotary encoder and OLED Display  

 

## Day 3
run the electric test , found some problems , got feedback on led wiring , fix it while waiting for more feedback on #keeb 

   

## Day 4     
didn't do anything today, i was working on another project   

## day 5  
finish solving the led problem and schematics, research abt footprints, will assign them tmr  
 
## day 6  
finished assigning the footprint , now welcome to wiring hell , also i'll be gone for two days so day 7 & 8 won't be any update    
  

# now from this point on i made lots of stupid mistake and time consuming that would have not happen if i do more research before hand 

# day9&10  
change my switch to kalih HS switch , started the layout for my keyboard , wondering how to add usb c power to my pcb  
(editing matthew here) yeah so i didn't know kle placer exist at this point so i manually align all my keys which is very time consuming and not consistent at all   

  

# day11  
i opted to switch to clone pico that have usb C , i'm also finished with the layout of the switches but i still got some question so imma wait for some feedback from #keeb (ouff turns out my capacitors are wrong , i switched to ceramic ones) and i also you're suppose to flip the HS Socket and the Led   

   

# day 12    

did nothing particular today   

# day 13    

routed the first row of the keyboard , will continue tmr.   
 

# day 14 15 16 17   

ok so i didn't do much these four days because i was soldering my blinker which didn't work :(  
# day 18   

ok so big update so i deleted all my trace that i wire on day 13 bcs it's too messy and the 5v trace is too thin. i also change my
diode to smd components. i also placed more components down and i decide to switch the diodes position to the side of the switch instead of on top.   

# day 19  
alright so i work on the led placement and holy hell i made a mistake   
(editing matthew here) so i think the mistake i made here was not flipping the switch and led so i have to delete the trace that i made , also check out this absolute ridiculous capacitor.  
    

# day 20  
contemplating my design choice   
(editing matthew here) so i thought i show u guys how i been arranging my HS socket , im basically eyeballing it with a refrence image   

   

# from this point on is where i did a lot redesigning and i also did a theme change , what theme ? well it's in the name 

# day 21   
ok after watching a few tutorial , i refined the schematics of my key switch matrix and switch out the mcp23008 extension chip with mcp22017 chip and as for the pcb it itself it's back to square one.   

   

# day 22  
ok so today i log a small section like 35min , so i learn how to use a placer to help me place my keyswitch to my KLE layout that i want , i also have some issue with the layout as the keyswitch number don't match when i do geographical reannotation  

   

# day 23    

today i work on more of my layout and finished placing all the components for my layout , but when i run DRC there seem to some issue with LED board edge clearance so i ask on #keeb and haven't started to route my pcb yet  

   

# day 24    

ok so today i solve the clearance issue and route the pcb thou im only like 45% done    
   

# day 25    

ok so today i finish most of the wiring just the led that is still unroute   
   

# day 26
did nothing, fr really tired that day    

# day 27  
so today i routed the led (ongoing) and i fix some issue col7 unrouted and added two capacitor for both the OLED screen and the Mcp23017 controller  
   

# day28  

today i added a ground plane to my pcb and finish routing the led and buddy there's tons of issue with gnd between the led ps: i totally forgot abt journaling yesterday so there won't be any picture today    

# day29   

so today i did lots of work i fix the ground issue and now im working to place the capacitor at the ideal position so we're at the very last stage of pcb designing , and oh the deadline is approaching fast. i wonder if i'll finish in time .     

# day 30    

alright today i got my finish routing my PCB and ran into issue with the capacitor , but other than i decided to do a major theme change to go more inline with the theme of my setup. i fix the capacitor issue and now placing the 3d key switch model manually one at a time   
  

# day 31     

today i finished my pcb and place all the 3d models , started on the case but there's an issue with fusion stp file import, but i found a workaround so no biggie thou there's not much time left.    
   

# day 32     
this is the last day before the deadline, so i pushed hard and hit a new record for time spend in front of a computer almost 6 hours and half of the time is just me failing and trying again
. i made the bottom case and the plate and boy do i fail a lot, it's so hard to judge the distance and sometimes i even get the range wrong and i have to redo everything, there's also random miniusclue gaps that will left out when i extrude and it's always so frustating to fix it  
anyway i think i have some pictures of the progress i made but idk.  

# day 33   
alright so today i decided to switch to the stardance challenge and ship my keyboard there.  

 # Devblog 1 
 so today i went back to the pcb and added more graphics cause why not , i got more time now   
 (editing matthew here) every blog from now  on will follow this format.   

 # Devblog 2   
 so what i did today, i continue working on my keyboard cad files today, boy o boy is tiring , i have to manually place and align each keycap and it took a while bcs im such a perfectionist. anyway i decided to use a top mount layout for my keyboard so there will three layer a bottom case , the plate and the upper case. im so impatient , i want to finish this quickly !!! 
   

# Devblog 3   
so this few days i just been doing CAD , the plate finish , i got the top case rough shape finish and i almost finish the bottom case just the usb-c port left. i went through three different design variations and eventually settle down for the design for the bottom case (in picture). i also model my own custom rotary encoder knob. i want to import a knurl design at first but then the model i import was too large and when i scale it down it won’t fit. either way we’re getting close to finishing the design phase.    
 

# Devblog 4   
this is it im done with my case

this is it we’re done with the designing phase ,
things i did:

   * changed the 3d model of the pi pico with a usb c
   * cut out the upper case heatset insert hole
   * cut out space for the screw head sticking out at the plate
   * cut out the usb-c charger hole
   * rounded the case edges
   * oooo idk if u notice but there’s a big hole on top of pico
   * and that’s there on purpose so i can add a clear acrylic plate there.
   * oh yeah and the text there also have space below to insert some light dispersing material.
 

# Final Devblog   
this is the last devblog im posting before i ship my project for funding.

during this time period , i made some finishing touches to the Case , prep it for production and i am just writing and updating my repo constantly. anyway i think i done with this project for now gotta work on my website fr fr
enjoy this assembly animation i made :)

 

# hi turns out that's not the final devblog
so today 5/11/26 and yesterday i been setting up Rust and RMK firmware on my computer and i only just finish writing the firmware or at least what would be the firmware for my keyboard. anyway tutorial for RMK is almost non-existent, as i found only one japanese ytber covering this topic. so after i install RMK in my laptop, i create the project file for my firmware through the terminal then after that  i edited the keyboard.toml. at first i thought i have to manually type in the keyboard matrix turns out you can import kle json file into it but i did it before i realised it no biggie really. then i proceeded to manually type in the keymap cuz that's the only way. then that's it but no, there's more my keyboard uses a gpio extension chip to control my 4 other column of keys and the oled screen and encoder. well in the offical Rmk guide there's no section covering this subject so i have no idea how to actually integrate this gpio expander into the firmware. that's why the uf2 compilation fail, cuz there's an error.

// 5/11/26 just now  
so there's some typo issue and i have actually define 3 keymap layer but i only have one so the rust analyst is returning an error,  
so i change that to one and it's fix. 
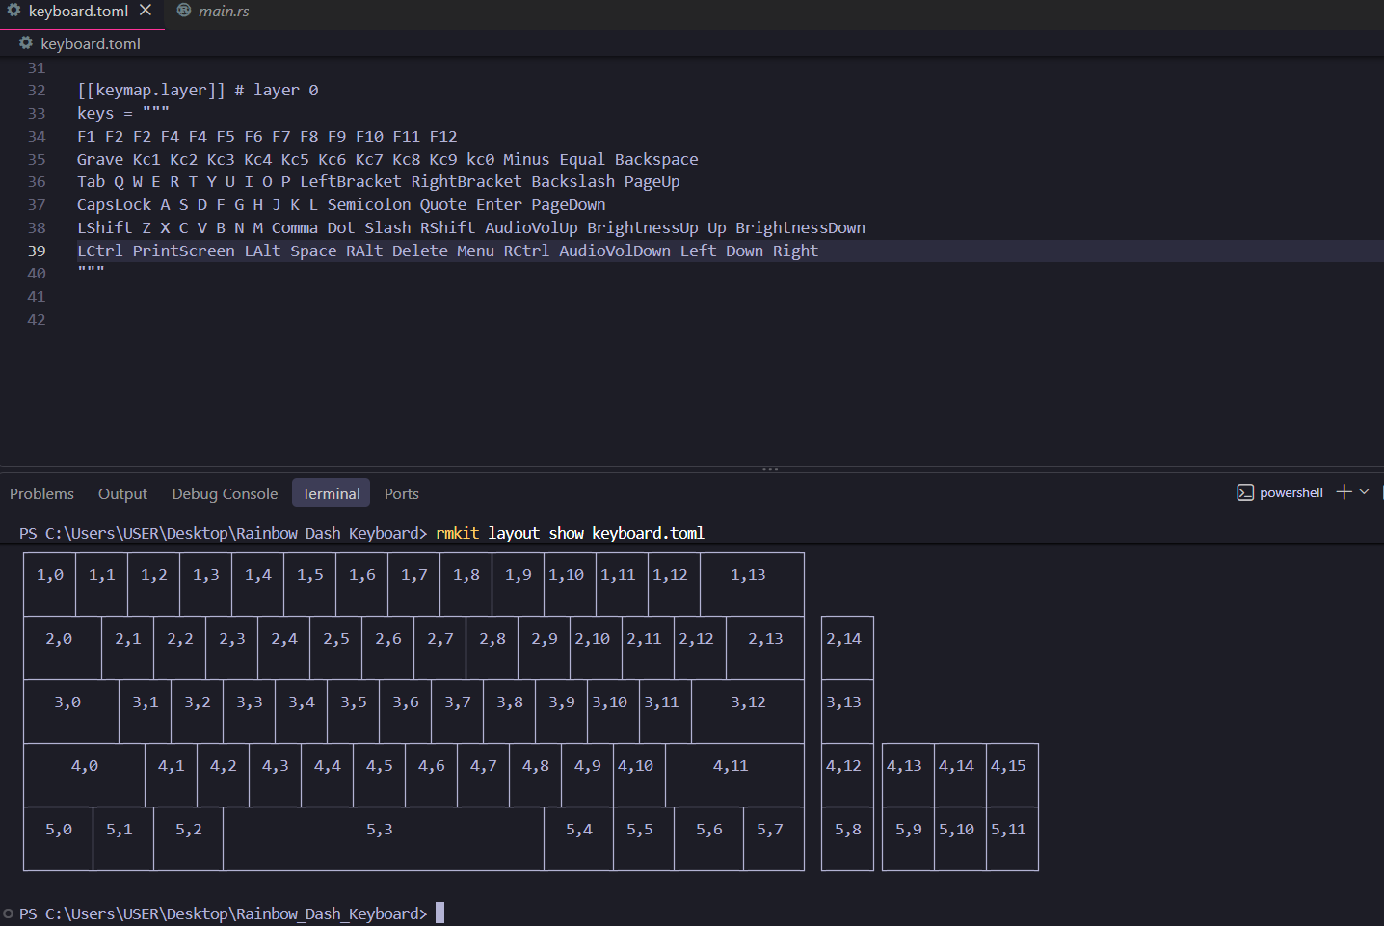
[picture p57: photo folder unlabel/Screenshot 2026-11-05 235412.png]
   
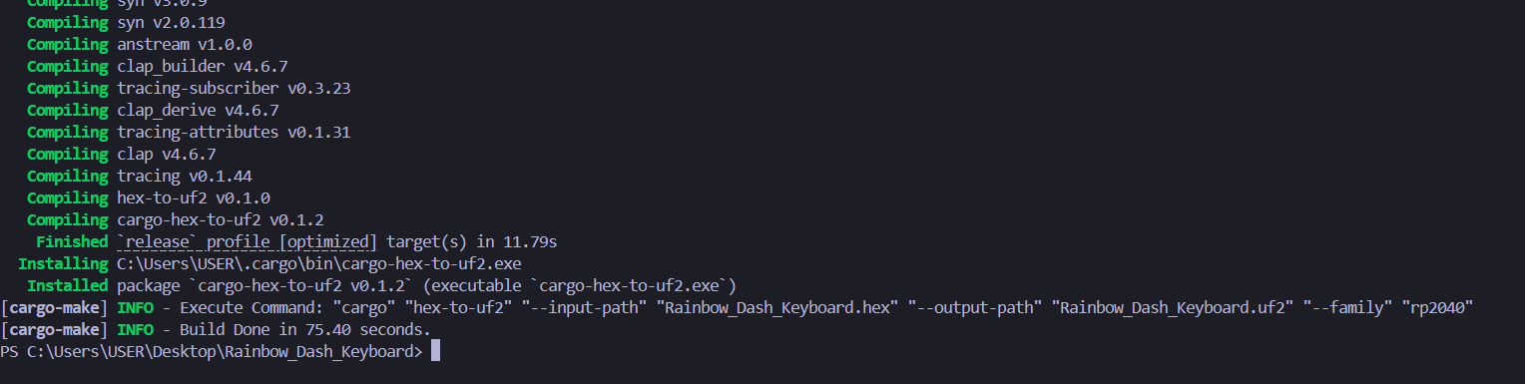
[picture p58: photo folder unlabel/Screenshot 2026-11-05 235824.png]
