Mattiplex/RAINBOW-DASH-Keyboard-/PCB FILE/RAINBOW DASH PCB.kicad_pcb

## KiCad design PCB FILE/RAINBOW DASH PCB.kicad_pcb (2026-10-15)

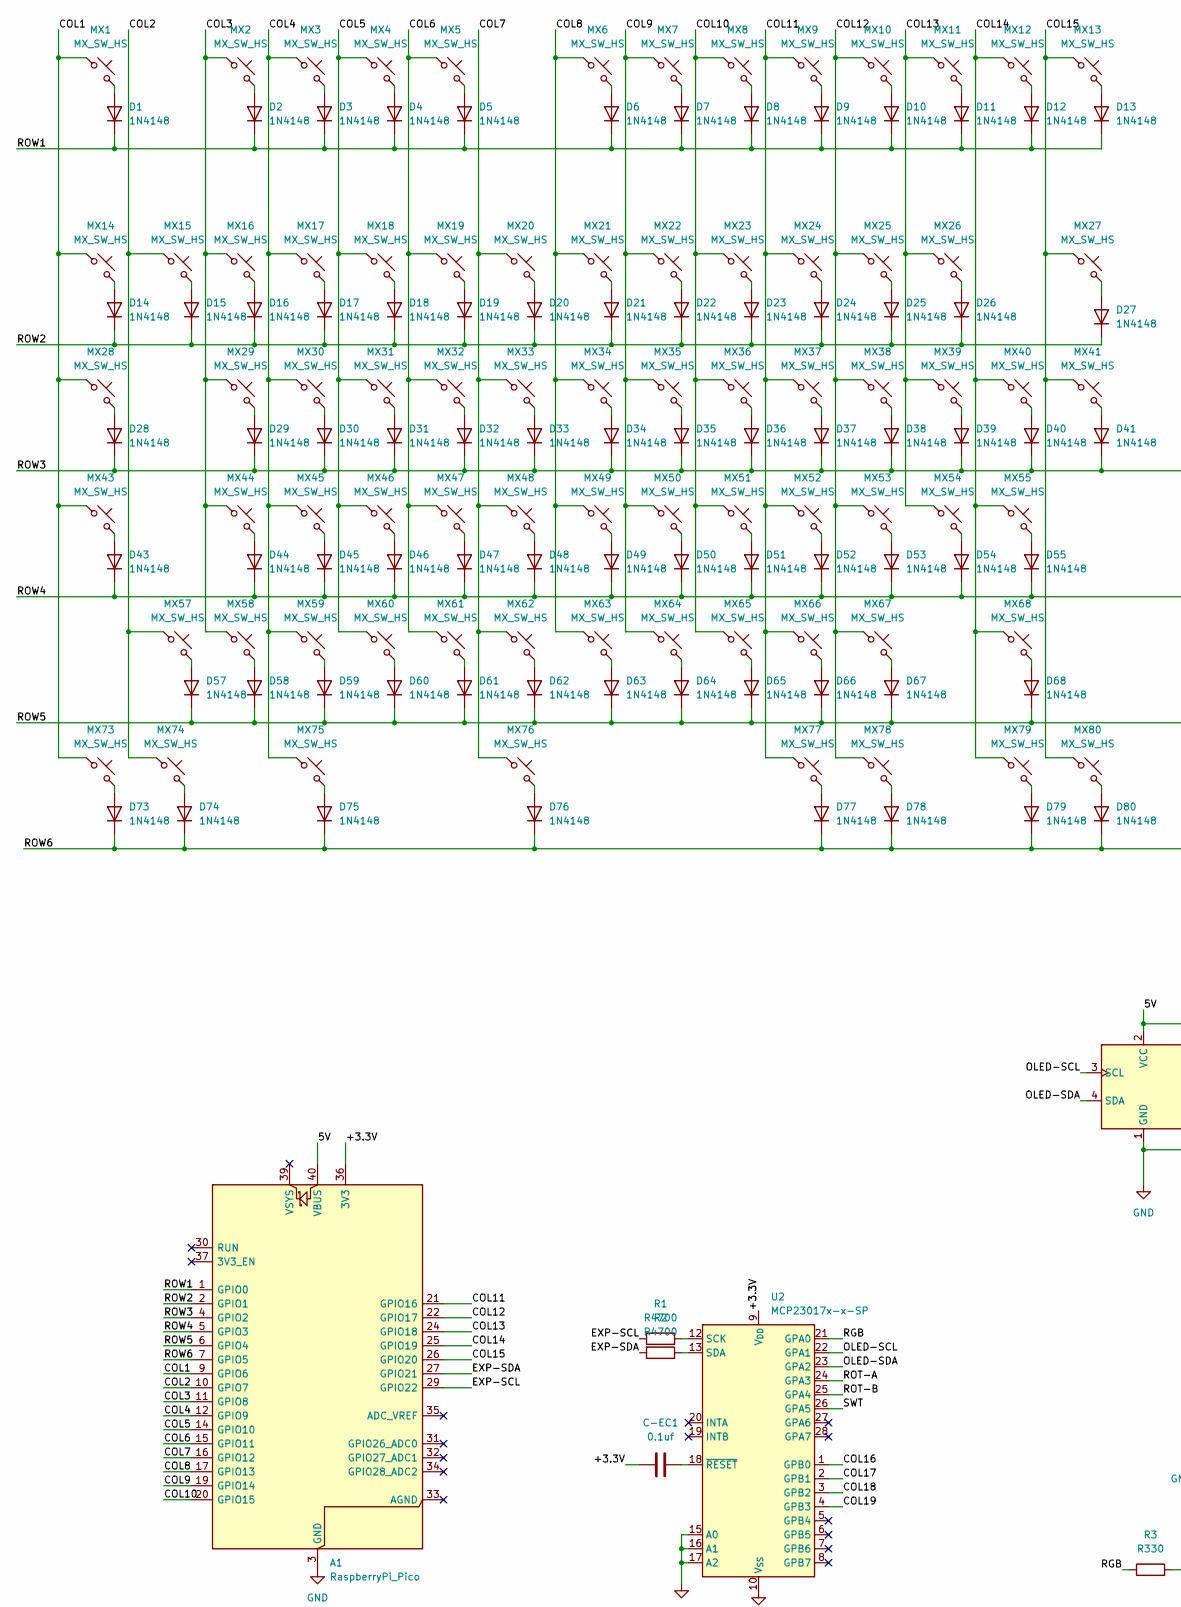
[picture p59: schematic Keyboard Schematics.kicad_sch, part in row 1, column 1]

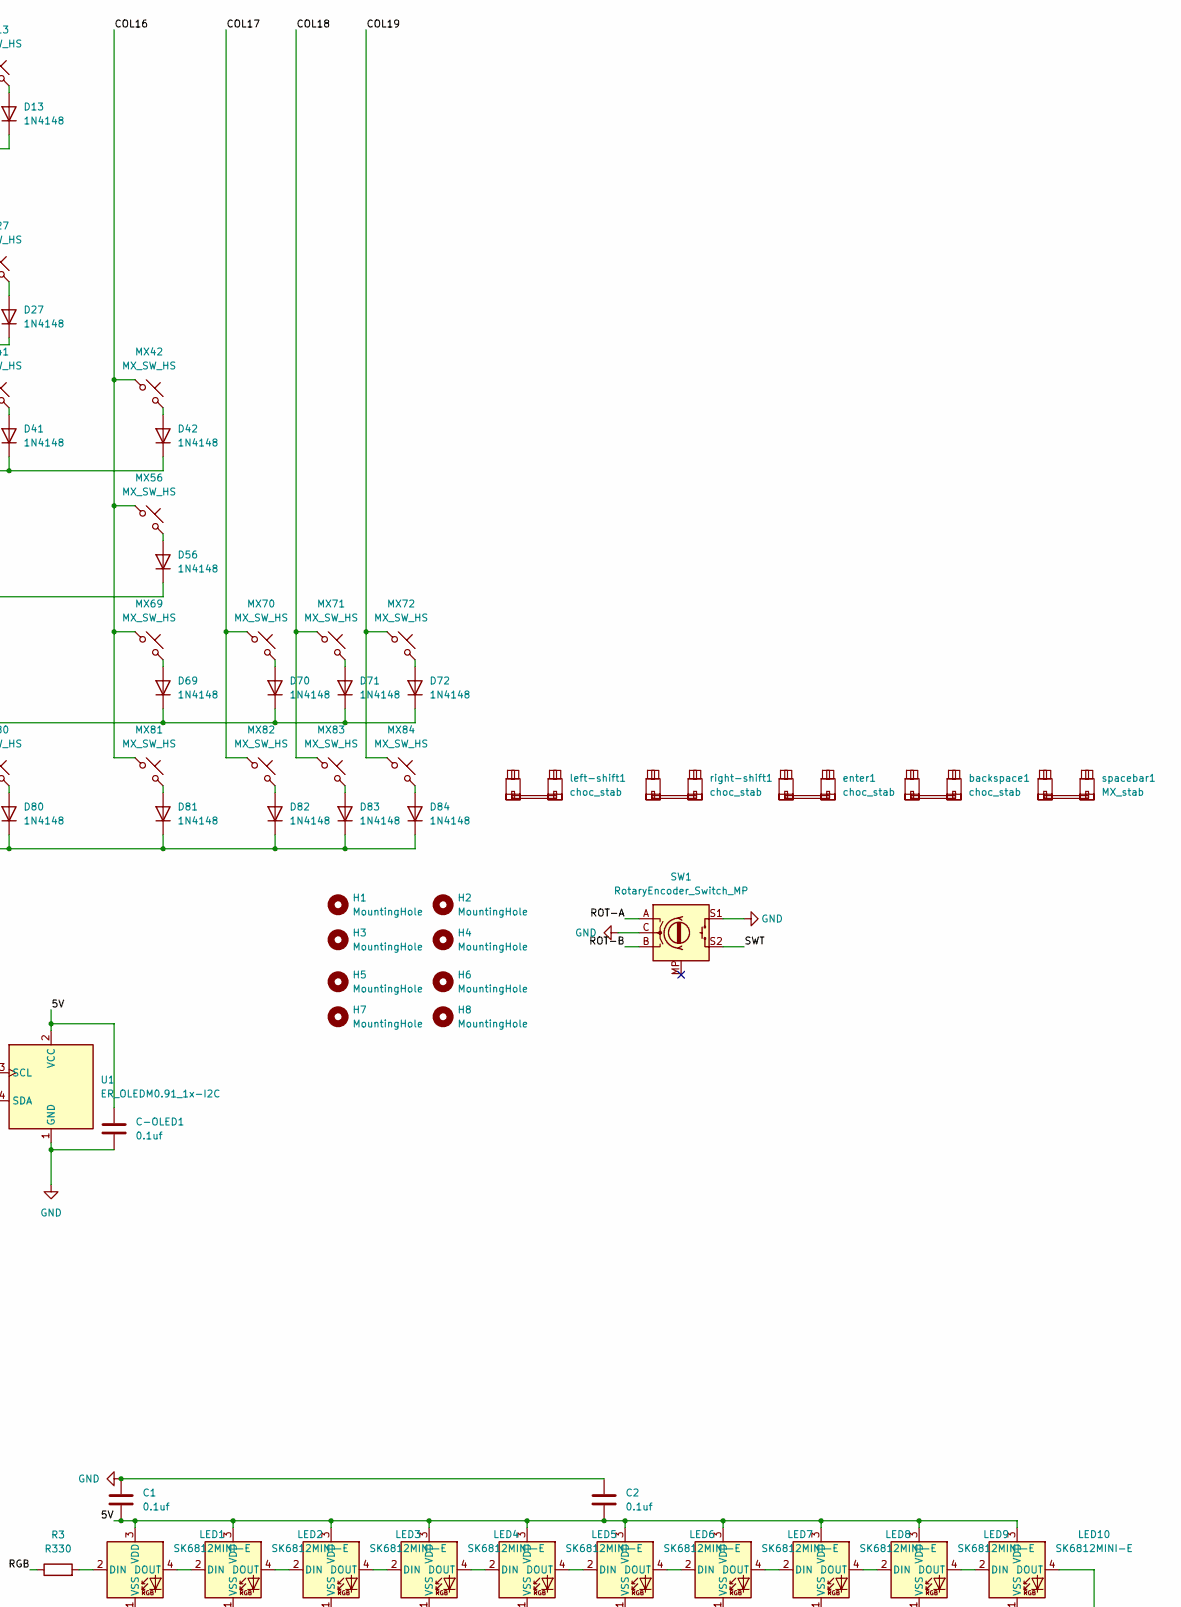
[picture p60: schematic Keyboard Schematics.kicad_sch, part in row 1, column 2]

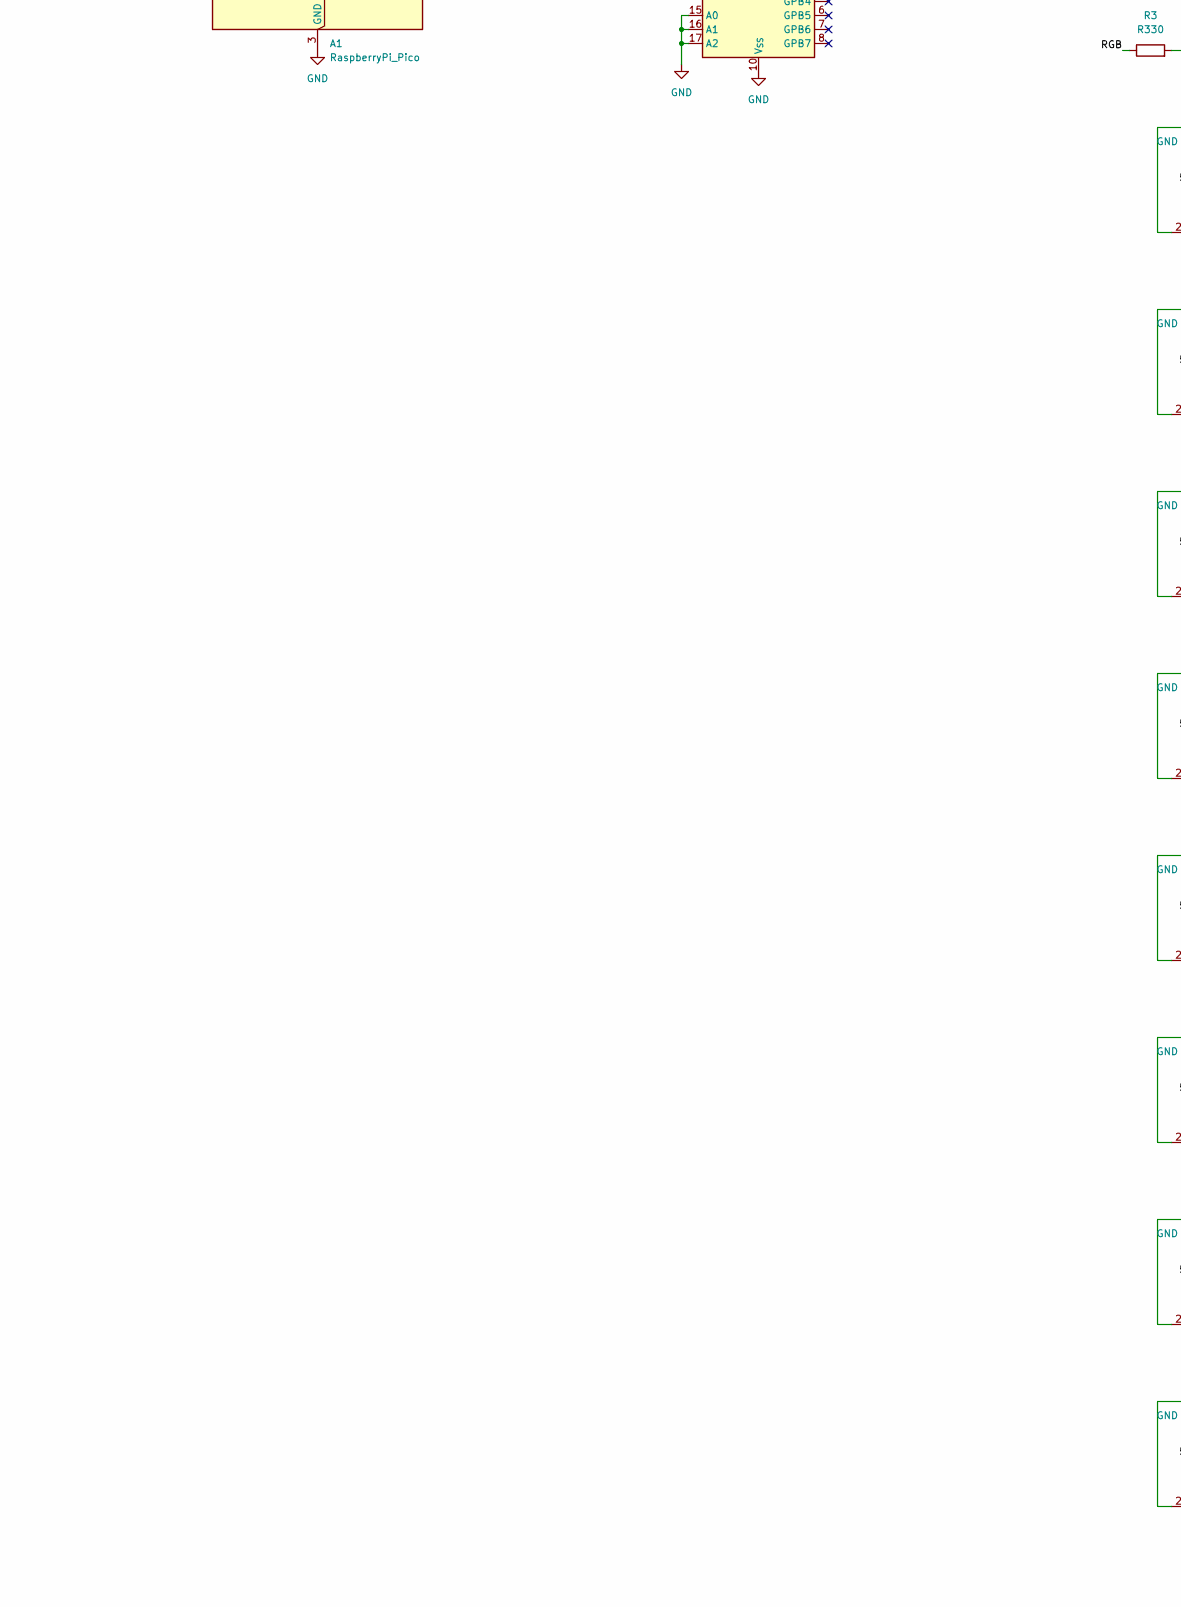
[picture p61: schematic Keyboard Schematics.kicad_sch, part in row 2, column 1]

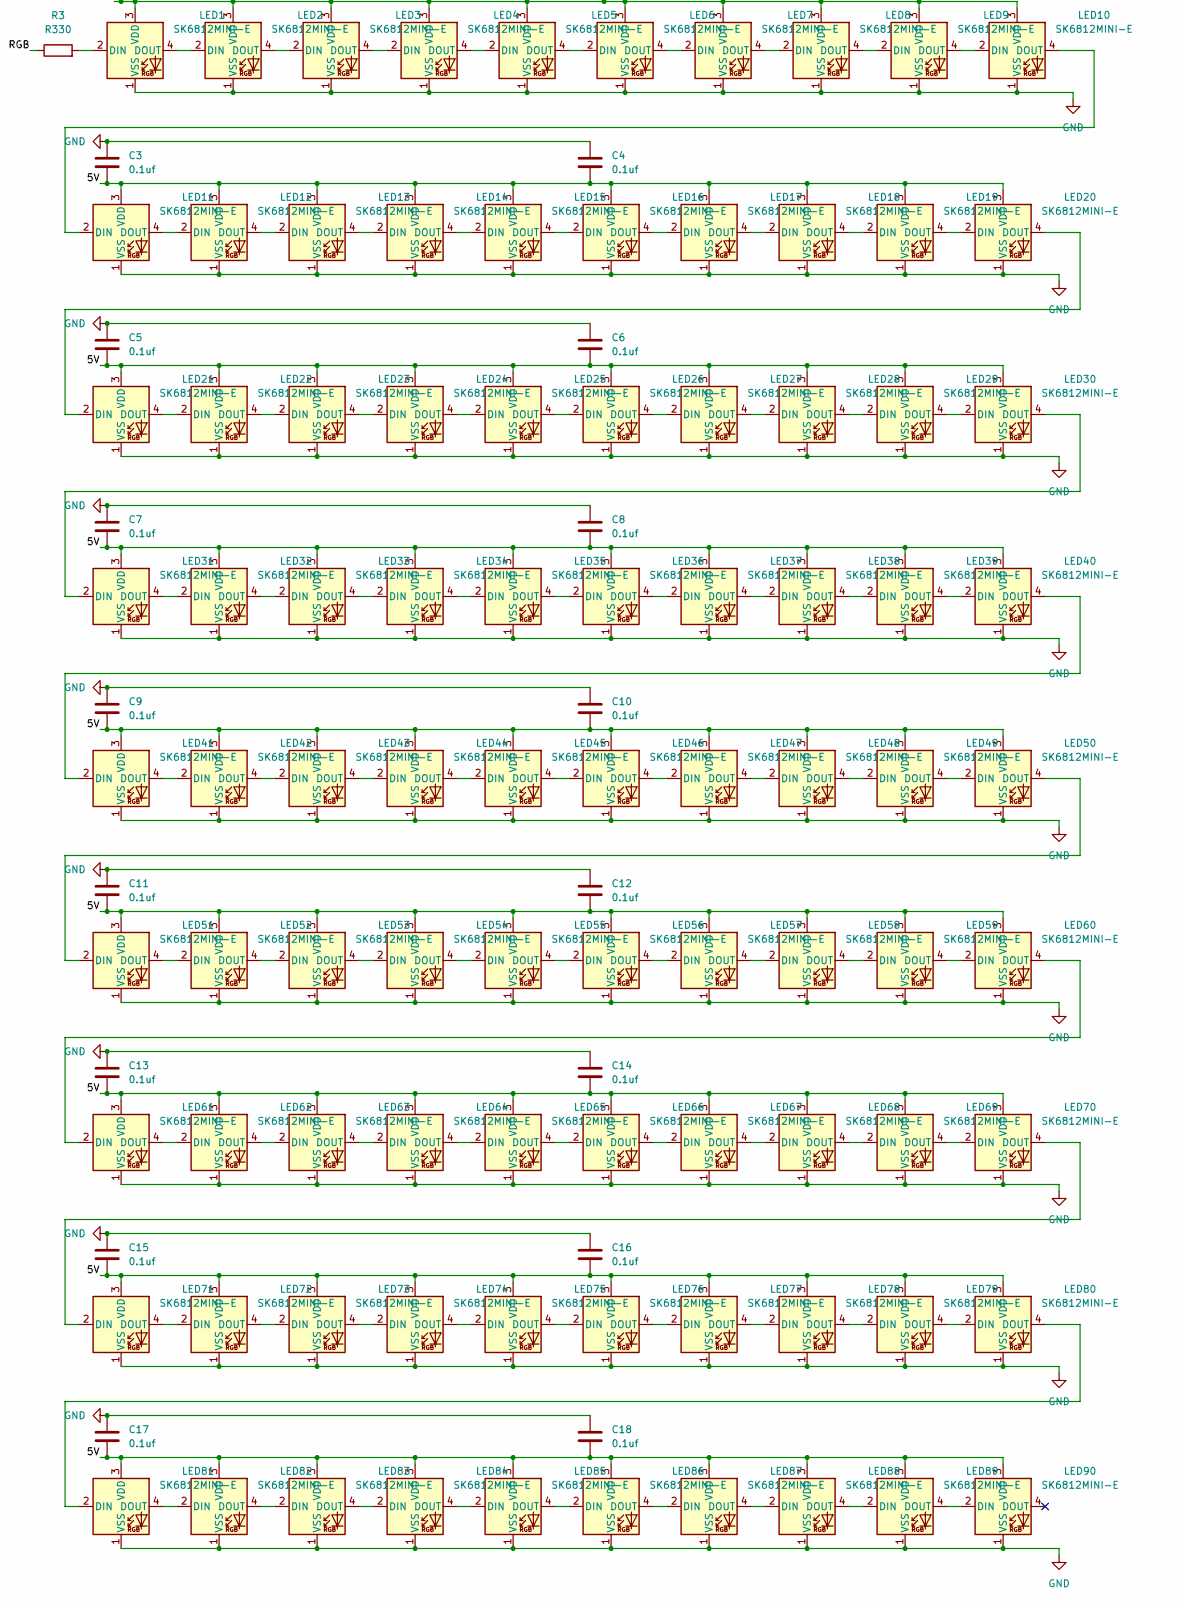
[picture p62: schematic Keyboard Schematics.kicad_sch, part in row 2, column 2]

Parts:
A1: RaspberryPi_Pico; RaspberryPi_Pico_Common_THT
C1, C2, C3, C4, C5, C6, C7, C8, C9, C10, C11, C12, C13, C14, C15, C16, C17, C18: 0.1uf; C_0805_2012Metric_Pad1.18x1.45mm_HandSolder
C-EC1: 0.1uf; C_0805_2012Metric_Pad1.18x1.45mm_HandSolder
C-OLED1: 0.1uf; C_0805_2012Metric_Pad1.18x1.45mm_HandSolder
D1, D2, D3, D4, D5, D6, D7, D8, D9, D10, D11, D12, D13, D14, D15, D16, D17, D18, D19, D20, D21, D22, D23, D24, D25, D26, D27, D28, D29, D30, D31, D32, D33, D34, D35, D36, D37, D38, D39, D40, D41, D42, D43, D44, D45, D46, D47, D48, D49, D50, D51, D52, D53, D54, D55, D56, D57, D58, D59, D60, D61, D62, D63, D64, D65, D66, D67, D68, D69, D70, D71, D72, D73, D74, D75, D76, D77, D78, D79, D80, D81, D82, D83, D84: 1N4148; D_0805_2012Metric
H1, H2, H3, H4, H5, H6, H7, H8: MountingHole; MountingHole_2.2mm_M2
LED1, LED2, LED3, LED4, LED5, LED6, LED7, LED8, LED9, LED10, LED11, LED12, LED13, LED14, LED15, LED16, LED17, LED18, LED19, LED20, LED21, LED22, LED23, LED24, LED25, LED26, LED27, LED28, LED29, LED30, LED31, LED32, LED33, LED34, LED35, LED36, LED37, LED38, LED39, LED40, LED41, LED42, LED43, LED44, LED45, LED46, LED47, LED48, LED49, LED50, LED51, LED52, LED53, LED54, LED55, LED56, LED57, LED58, LED59, LED60, LED61, LED62, LED63, LED64, LED65, LED66, LED67, LED68, LED69, LED70, LED71, LED72, LED73, LED74, LED75, LED76, LED77, LED78, LED79, LED80, LED81, LED82, LED83, LED84, LED85, LED86, LED87, LED88, LED89, LED90: SK6812MINI-E; LED_SK6812MINI-E_3.2x2.8mm_P1.5mm_ReverseMount
MX1, MX2, MX3, MX4, MX5, MX6, MX7, MX8, MX9, MX10, MX11, MX12, MX13, MX14, MX15, MX16, MX17, MX18, MX19, MX20, MX21, MX22, MX23, MX24, MX25, MX26, MX27, MX28, MX29, MX30, MX31, MX32, MX33, MX34, MX35, MX36, MX37, MX38, MX39, MX40, MX41, MX42, MX43, MX44, MX45, MX46, MX47, MX48, MX49, MX50, MX51, MX52, MX53, MX54, MX55, MX56, MX57, MX58, MX59, MX60, MX61, MX62, MX63, MX64, MX65, MX66, MX67, MX68, MX69, MX70, MX71, MX72, MX73, MX74, MX75, MX76, MX77, MX78, MX79, MX80, MX81, MX82, MX83, MX84: MX_SW_HS; SW_MX_HS_CPG151101S11_1u
R1, R2: R4700; R_Axial_DIN0207_L6.3mm_D2.5mm_P10.16mm_Horizontal
R3: R330; R_Axial_DIN0207_L6.3mm_D2.5mm_P10.16mm_Horizontal
SW1: RotaryEncoder_Switch_MP; ROT_Alps_EC11E-Switch
U1: ER_OLEDM0.91_1x-I2C
U2: MCP23017x-x-SP; DIP-28_W7.62mm_LongPads
backspace1: choc_stab; STAB_MX_2u
enter1: choc_stab; STAB_MX_2.25u
left-shift1: choc_stab; STAB_MX_2.25u
right-shift1: choc_stab; STAB_MX_2.75u
spacebar1: MX_stab; STAB_MX_6.25u

Connections:
/5V: A1.40 (VBUS), C1.1, C2.1, C3.1, C4.1, C5.1, C6.1, C7.1, C8.1, C9.1, C10.1, C11.1, C12.1, C13.1, C14.1, C15.1, C16.1, C17.1, C18.1, C-OLED1.1, LED1.3 (VDD), LED2.3 (VDD), LED3.3 (VDD), LED4.3 (VDD), LED5.3 (VDD), LED6.3 (VDD), LED7.3 (VDD), LED8.3 (VDD), LED9.3 (VDD), LED10.3 (VDD), LED11.3 (VDD), LED12.3 (VDD), LED13.3 (VDD), LED14.3 (VDD), LED15.3 (VDD), LED16.3 (VDD), LED17.3 (VDD), LED18.3 (VDD), LED19.3 (VDD), LED20.3 (VDD), LED21.3 (VDD), LED22.3 (VDD), LED23.3 (VDD), LED24.3 (VDD), LED25.3 (VDD), LED26.3 (VDD), LED27.3 (VDD), LED28.3 (VDD), LED29.3 (VDD), LED30.3 (VDD), LED31.3 (VDD), LED32.3 (VDD), LED33.3 (VDD), LED34.3 (VDD), LED35.3 (VDD), LED36.3 (VDD), LED37.3 (VDD), LED38.3 (VDD), LED39.3 (VDD), LED40.3 (VDD), LED41.3 (VDD), LED42.3 (VDD), LED43.3 (VDD), LED44.3 (VDD), LED45.3 (VDD), LED46.3 (VDD), LED47.3 (VDD), LED48.3 (VDD), LED49.3 (VDD), LED50.3 (VDD), LED51.3 (VDD), LED52.3 (VDD), LED53.3 (VDD), LED54.3 (VDD), LED55.3 (VDD), LED56.3 (VDD), LED57.3 (VDD), LED58.3 (VDD), LED59.3 (VDD), LED60.3 (VDD), LED61.3 (VDD), LED62.3 (VDD), LED63.3 (VDD), LED64.3 (VDD), LED65.3 (VDD), LED66.3 (VDD), LED67.3 (VDD), LED68.3 (VDD), LED69.3 (VDD), LED70.3 (VDD), LED71.3 (VDD), LED72.3 (VDD), LED73.3 (VDD), LED74.3 (VDD), LED75.3 (VDD), LED76.3 (VDD), LED77.3 (VDD), LED78.3 (VDD), LED79.3 (VDD), LED80.3 (VDD), LED81.3 (VDD), LED82.3 (VDD), LED83.3 (VDD), LED84.3 (VDD), LED85.3 (VDD), LED86.3 (VDD), LED87.3 (VDD), LED88.3 (VDD), LED89.3 (VDD), LED90.3 (VDD), U1.2 (VCC)
/+3.3V: A1.36 (3V3), C-EC1.1, U2.9 (V_{DD})
/COL1: A1.9 (GPIO6), MX1.1, MX14.1, MX28.1, MX43.1, MX73.1
/COL2: A1.10 (GPIO7), MX15.1, MX57.1, MX74.1
/COL3: A1.11 (GPIO8), MX2.1, MX16.1, MX29.1, MX44.1, MX58.1
/COL4: A1.12 (GPIO9), MX3.1, MX17.1, MX30.1, MX45.1, MX59.1, MX75.1
/COL5: A1.14 (GPIO10), MX4.1, MX18.1, MX31.1, MX46.1, MX60.1
/COL6: A1.15 (GPIO11), MX5.1, MX19.1, MX32.1, MX47.1, MX61.1
/COL7: A1.16 (GPIO12), MX20.1, MX33.1, MX48.1, MX62.1, MX76.1
/COL8: A1.17 (GPIO13), MX6.1, MX21.1, MX34.1, MX49.1, MX63.1
/COL9: A1.19 (GPIO14), MX7.1, MX22.1, MX35.1, MX50.1, MX64.1
/COL10: A1.20 (GPIO15), MX8.1, MX23.1, MX36.1, MX51.1, MX65.1
/COL11: A1.21 (GPIO16), MX9.1, MX24.1, MX37.1, MX52.1, MX66.1, MX77.1
/COL12: A1.22 (GPIO17), MX10.1, MX25.1, MX38.1, MX53.1, MX67.1, MX78.1
/COL13: A1.24 (GPIO18), MX11.1, MX26.1, MX39.1, MX54.1
/COL14: A1.25 (GPIO19), MX12.1, MX40.1, MX55.1, MX68.1, MX79.1
/COL15: A1.26 (GPIO20), MX13.1, MX27.1, MX41.1, MX80.1
/COL16: MX42.1, MX56.1, MX69.1, MX81.1, U2.1 (GPB0)
/COL17: MX70.1, MX82.1, U2.2 (GPB1)
/COL18: MX71.1, MX83.1, U2.3 (GPB2)
/COL19: MX72.1, MX84.1, U2.4 (GPB3)
/EXP-SCL: A1.29 (GPIO22), R1.2
/EXP-SDA: A1.27 (GPIO21), R2.2
/OLED-SCL: U1.3 (SCL), U2.22 (GPA1)
/OLED-SDA: U1.4 (SDA), U2.23 (GPA2)
/RGB: R3.1, U2.21 (GPA0)
/ROT-A: SW1.A, U2.24 (GPA3)
/ROT-B: SW1.B, U2.25 (GPA4)
/ROW1: A1.1 (GPIO0), D1.1 (K), D2.1 (K), D3.1 (K), D4.1 (K), D5.1 (K), D6.1 (K), D7.1 (K), D8.1 (K), D9.1 (K), D10.1 (K), D11.1 (K), D12.1 (K), D13.1 (K)
/ROW2: A1.2 (GPIO1), D14.1 (K), D15.1 (K), D16.1 (K), D17.1 (K), D18.1 (K), D19.1 (K), D20.1 (K), D21.1 (K), D22.1 (K), D23.1 (K), D24.1 (K), D25.1 (K), D26.1 (K), D27.1 (K)
/ROW3: A1.4 (GPIO2), D28.1 (K), D29.1 (K), D30.1 (K), D31.1 (K), D32.1 (K), D33.1 (K), D34.1 (K), D35.1 (K), D36.1 (K), D37.1 (K), D38.1 (K), D39.1 (K), D40.1 (K), D41.1 (K), D42.1 (K)
/ROW4: A1.5 (GPIO3), D43.1 (K), D44.1 (K), D45.1 (K), D46.1 (K), D47.1 (K), D48.1 (K), D49.1 (K), D50.1 (K), D51.1 (K), D52.1 (K), D53.1 (K), D54.1 (K), D55.1 (K), D56.1 (K)
/ROW5: A1.6 (GPIO4), D57.1 (K), D58.1 (K), D59.1 (K), D60.1 (K), D61.1 (K), D62.1 (K), D63.1 (K), D64.1 (K), D65.1 (K), D66.1 (K), D67.1 (K), D68.1 (K), D69.1 (K), D70.1 (K), D71.1 (K), D72.1 (K)
/ROW6: A1.7 (GPIO5), D73.1 (K), D74.1 (K), D75.1 (K), D76.1 (K), D77.1 (K), D78.1 (K), D79.1 (K), D80.1 (K), D81.1 (K), D82.1 (K), D83.1 (K), D84.1 (K)
/SWT: SW1.S2, U2.26 (GPA5)
GND: A1.3 (GND), A1.8 (GND), A1.13 (GND), A1.18 (GND), A1.23 (GND), A1.28 (GND), A1.38 (GND), C1.2, C2.2, C3.2, C4.2, C5.2, C6.2, C7.2, C8.2, C9.2, C10.2, C11.2, C12.2, C13.2, C14.2, C15.2, C16.2, C17.2, C18.2, C-OLED1.2, LED1.1 (VSS), LED2.1 (VSS), LED3.1 (VSS), LED4.1 (VSS), LED5.1 (VSS), LED6.1 (VSS), LED7.1 (VSS), LED8.1 (VSS), LED9.1 (VSS), LED10.1 (VSS), LED11.1 (VSS), LED12.1 (VSS), LED13.1 (VSS), LED14.1 (VSS), LED15.1 (VSS), LED16.1 (VSS), LED17.1 (VSS), LED18.1 (VSS), LED19.1 (VSS), LED20.1 (VSS), LED21.1 (VSS), LED22.1 (VSS), LED23.1 (VSS), LED24.1 (VSS), LED25.1 (VSS), LED26.1 (VSS), LED27.1 (VSS), LED28.1 (VSS), LED29.1 (VSS), LED30.1 (VSS), LED31.1 (VSS), LED32.1 (VSS), LED33.1 (VSS), LED34.1 (VSS), LED35.1 (VSS), LED36.1 (VSS), LED37.1 (VSS), LED38.1 (VSS), LED39.1 (VSS), LED40.1 (VSS), LED41.1 (VSS), LED42.1 (VSS), LED43.1 (VSS), LED44.1 (VSS), LED45.1 (VSS), LED46.1 (VSS), LED47.1 (VSS), LED48.1 (VSS), LED49.1 (VSS), LED50.1 (VSS), LED51.1 (VSS), LED52.1 (VSS), LED53.1 (VSS), LED54.1 (VSS), LED55.1 (VSS), LED56.1 (VSS), LED57.1 (VSS), LED58.1 (VSS), LED59.1 (VSS), LED60.1 (VSS), LED61.1 (VSS), LED62.1 (VSS), LED63.1 (VSS), LED64.1 (VSS), LED65.1 (VSS), LED66.1 (VSS), LED67.1 (VSS), LED68.1 (VSS), LED69.1 (VSS), LED70.1 (VSS), LED71.1 (VSS), LED72.1 (VSS), LED73.1 (VSS), LED74.1 (VSS), LED75.1 (VSS), LED76.1 (VSS), LED77.1 (VSS), LED78.1 (VSS), LED79.1 (VSS), LED80.1 (VSS), LED81.1 (VSS), LED82.1 (VSS), LED83.1 (VSS), LED84.1 (VSS), LED85.1 (VSS), LED86.1 (VSS), LED87.1 (VSS), LED88.1 (VSS), LED89.1 (VSS), LED90.1 (VSS), SW1.C, SW1.S1, U1.1 (GND), U2.10 (V_{SS}), U2.15 (A0), U2.16 (A1), U2.17 (A2)
unnamed: D1.2 (A), MX1.2
unnamed: D2.2 (A), MX2.2
unnamed: D3.2 (A), MX3.2
unnamed: D4.2 (A), MX4.2
unnamed: D5.2 (A), MX5.2
unnamed: D6.2 (A), MX6.2
unnamed: D7.2 (A), MX7.2
unnamed: D8.2 (A), MX8.2
unnamed: D9.2 (A), MX9.2
unnamed: D10.2 (A), MX10.2
unnamed: D11.2 (A), MX11.2
unnamed: D12.2 (A), MX12.2
unnamed: D13.2 (A), MX13.2
unnamed: D14.2 (A), MX14.2
unnamed: D15.2 (A), MX15.2
unnamed: D16.2 (A), MX16.2
unnamed: D17.2 (A), MX17.2
unnamed: D18.2 (A), MX18.2
unnamed: D19.2 (A), MX19.2
unnamed: D20.2 (A), MX20.2
unnamed: D21.2 (A), MX21.2
unnamed: D22.2 (A), MX22.2
unnamed: D23.2 (A), MX23.2
unnamed: D24.2 (A), MX24.2
unnamed: D25.2 (A), MX25.2
unnamed: D26.2 (A), MX26.2
unnamed: D27.2 (A), MX27.2
unnamed: D28.2 (A), MX28.2
unnamed: D29.2 (A), MX29.2
unnamed: D30.2 (A), MX30.2
unnamed: D31.2 (A), MX31.2
unnamed: D32.2 (A), MX32.2
unnamed: D33.2 (A), MX33.2
unnamed: D34.2 (A), MX34.2
unnamed: D35.2 (A), MX35.2
unnamed: D36.2 (A), MX36.2
unnamed: D37.2 (A), MX37.2
unnamed: D38.2 (A), MX38.2
unnamed: D39.2 (A), MX39.2
unnamed: D40.2 (A), MX40.2
unnamed: D41.2 (A), MX41.2
unnamed: D42.2 (A), MX42.2
unnamed: D43.2 (A), MX43.2
unnamed: D44.2 (A), MX44.2
unnamed: D45.2 (A), MX45.2
unnamed: D46.2 (A), MX46.2
unnamed: D47.2 (A), MX47.2
unnamed: D48.2 (A), MX48.2
unnamed: D49.2 (A), MX49.2
unnamed: D50.2 (A), MX50.2
unnamed: D51.2 (A), MX51.2
unnamed: D52.2 (A), MX52.2
unnamed: D53.2 (A), MX53.2
unnamed: D54.2 (A), MX54.2
unnamed: D55.2 (A), MX55.2
unnamed: D56.2 (A), MX56.2
unnamed: D57.2 (A), MX57.2
unnamed: D58.2 (A), MX58.2
unnamed: D59.2 (A), MX59.2
unnamed: D60.2 (A), MX60.2
unnamed: D61.2 (A), MX61.2
unnamed: D62.2 (A), MX62.2
unnamed: D63.2 (A), MX63.2
unnamed: D64.2 (A), MX64.2
unnamed: D65.2 (A), MX65.2
unnamed: D66.2 (A), MX66.2
unnamed: D67.2 (A), MX67.2
unnamed: D68.2 (A), MX68.2
unnamed: D69.2 (A), MX69.2
unnamed: D70.2 (A), MX70.2
unnamed: D71.2 (A), MX71.2
unnamed: D72.2 (A), MX72.2
unnamed: D73.2 (A), MX73.2
unnamed: D74.2 (A), MX74.2
unnamed: D75.2 (A), MX75.2
unnamed: D76.2 (A), MX76.2
unnamed: D77.2 (A), MX77.2
unnamed: D78.2 (A), MX78.2
unnamed: D79.2 (A), MX79.2
unnamed: D80.2 (A), MX80.2
unnamed: D81.2 (A), MX81.2
unnamed: D82.2 (A), MX82.2
unnamed: D83.2 (A), MX83.2
unnamed: D84.2 (A), MX84.2
unnamed: LED1.2 (DIN), R3.2
unnamed: LED1.4 (DOUT), LED2.2 (DIN)
unnamed: LED2.4 (DOUT), LED3.2 (DIN)
unnamed: LED3.4 (DOUT), LED4.2 (DIN)
unnamed: LED4.4 (DOUT), LED5.2 (DIN)
unnamed: LED5.4 (DOUT), LED6.2 (DIN)
unnamed: LED6.4 (DOUT), LED7.2 (DIN)
unnamed: LED7.4 (DOUT), LED8.2 (DIN)
unnamed: LED8.4 (DOUT), LED9.2 (DIN)
unnamed: LED9.4 (DOUT), LED10.2 (DIN)
unnamed: LED10.4 (DOUT), LED11.2 (DIN)
unnamed: LED11.4 (DOUT), LED12.2 (DIN)
unnamed: LED12.4 (DOUT), LED13.2 (DIN)
unnamed: LED13.4 (DOUT), LED14.2 (DIN)
unnamed: LED14.4 (DOUT), LED15.2 (DIN)
unnamed: LED15.4 (DOUT), LED16.2 (DIN)
unnamed: LED16.4 (DOUT), LED17.2 (DIN)
unnamed: LED17.4 (DOUT), LED18.2 (DIN)
unnamed: LED18.4 (DOUT), LED19.2 (DIN)
unnamed: LED19.4 (DOUT), LED20.2 (DIN)
unnamed: LED20.4 (DOUT), LED21.2 (DIN)
unnamed: LED21.4 (DOUT), LED22.2 (DIN)
unnamed: LED22.4 (DOUT), LED23.2 (DIN)
unnamed: LED23.4 (DOUT), LED24.2 (DIN)
unnamed: LED24.4 (DOUT), LED25.2 (DIN)
unnamed: LED25.4 (DOUT), LED26.2 (DIN)
unnamed: LED26.4 (DOUT), LED27.2 (DIN)
unnamed: LED27.4 (DOUT), LED28.2 (DIN)
unnamed: LED28.4 (DOUT), LED29.2 (DIN)
unnamed: LED29.4 (DOUT), LED30.2 (DIN)
unnamed: LED30.4 (DOUT), LED31.2 (DIN)
unnamed: LED31.4 (DOUT), LED32.2 (DIN)
unnamed: LED32.4 (DOUT), LED33.2 (DIN)
unnamed: LED33.4 (DOUT), LED34.2 (DIN)
unnamed: LED34.4 (DOUT), LED35.2 (DIN)
unnamed: LED35.4 (DOUT), LED36.2 (DIN)
unnamed: LED36.4 (DOUT), LED37.2 (DIN)
unnamed: LED37.4 (DOUT), LED38.2 (DIN)
unnamed: LED38.4 (DOUT), LED39.2 (DIN)
unnamed: LED39.4 (DOUT), LED40.2 (DIN)
unnamed: LED40.4 (DOUT), LED41.2 (DIN)
unnamed: LED41.4 (DOUT), LED42.2 (DIN)
unnamed: LED42.4 (DOUT), LED43.2 (DIN)
unnamed: LED43.4 (DOUT), LED44.2 (DIN)
unnamed: LED44.4 (DOUT), LED45.2 (DIN)
unnamed: LED45.4 (DOUT), LED46.2 (DIN)
unnamed: LED46.4 (DOUT), LED47.2 (DIN)
unnamed: LED47.4 (DOUT), LED48.2 (DIN)
unnamed: LED48.4 (DOUT), LED49.2 (DIN)
unnamed: LED49.4 (DOUT), LED50.2 (DIN)
unnamed: LED50.4 (DOUT), LED51.2 (DIN)
unnamed: LED51.4 (DOUT), LED52.2 (DIN)
unnamed: LED52.4 (DOUT), LED53.2 (DIN)
unnamed: LED53.4 (DOUT), LED54.2 (DIN)
unnamed: LED54.4 (DOUT), LED55.2 (DIN)
unnamed: LED55.4 (DOUT), LED56.2 (DIN)
unnamed: LED56.4 (DOUT), LED57.2 (DIN)
unnamed: LED57.4 (DOUT), LED58.2 (DIN)
unnamed: LED58.4 (DOUT), LED59.2 (DIN)
unnamed: LED59.4 (DOUT), LED60.2 (DIN)
unnamed: LED60.4 (DOUT), LED61.2 (DIN)
unnamed: LED61.4 (DOUT), LED62.2 (DIN)
unnamed: LED62.4 (DOUT), LED63.2 (DIN)
unnamed: LED63.4 (DOUT), LED64.2 (DIN)
unnamed: LED64.4 (DOUT), LED65.2 (DIN)
unnamed: LED65.4 (DOUT), LED66.2 (DIN)
unnamed: LED66.4 (DOUT), LED67.2 (DIN)
unnamed: LED67.4 (DOUT), LED68.2 (DIN)
unnamed: LED68.4 (DOUT), LED69.2 (DIN)
unnamed: LED69.4 (DOUT), LED70.2 (DIN)
unnamed: LED70.4 (DOUT), LED71.2 (DIN)
unnamed: LED71.4 (DOUT), LED72.2 (DIN)
unnamed: LED72.4 (DOUT), LED73.2 (DIN)
unnamed: LED73.4 (DOUT), LED74.2 (DIN)
unnamed: LED74.4 (DOUT), LED75.2 (DIN)
unnamed: LED75.4 (DOUT), LED76.2 (DIN)
unnamed: LED76.4 (DOUT), LED77.2 (DIN)
unnamed: LED77.4 (DOUT), LED78.2 (DIN)
unnamed: LED78.4 (DOUT), LED79.2 (DIN)
unnamed: LED79.4 (DOUT), LED80.2 (DIN)
unnamed: LED80.4 (DOUT), LED81.2 (DIN)
unnamed: LED81.4 (DOUT), LED82.2 (DIN)
unnamed: LED82.4 (DOUT), LED83.2 (DIN)
unnamed: LED83.4 (DOUT), LED84.2 (DIN)
unnamed: LED84.4 (DOUT), LED85.2 (DIN)
unnamed: LED85.4 (DOUT), LED86.2 (DIN)
unnamed: LED86.4 (DOUT), LED87.2 (DIN)
unnamed: LED87.4 (DOUT), LED88.2 (DIN)
unnamed: LED88.4 (DOUT), LED89.2 (DIN)
unnamed: LED89.4 (DOUT), LED90.2 (DIN)
unnamed: R1.1, U2.12 (SCK)
unnamed: R2.1, U2.13 (SDA)
unnamed: C-EC1.2, U2.18 (~RESET)

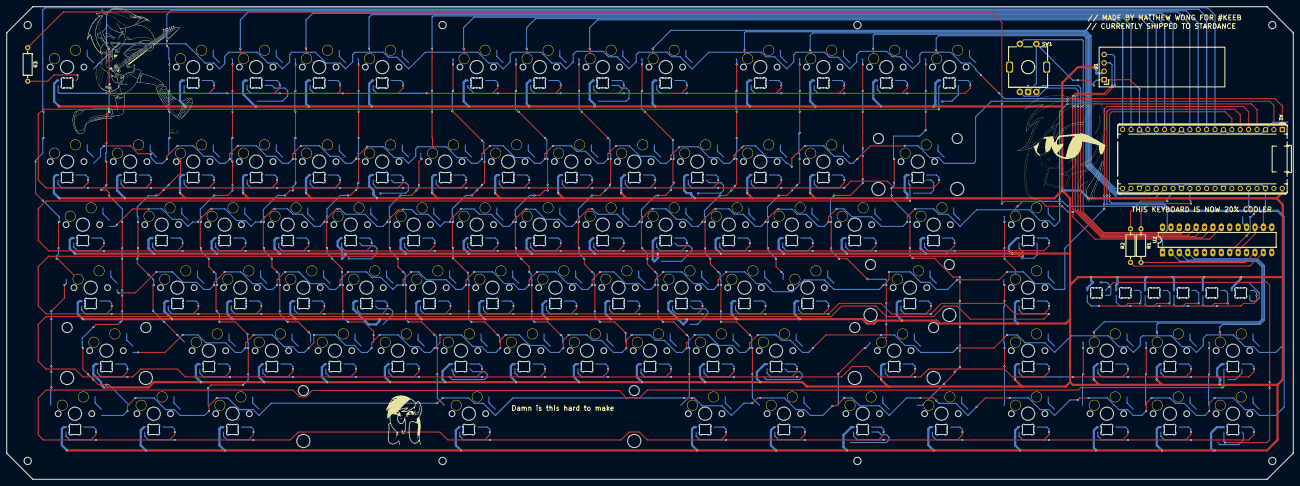
[picture p63: board RAINBOW DASH PCB.kicad_pcb from above]

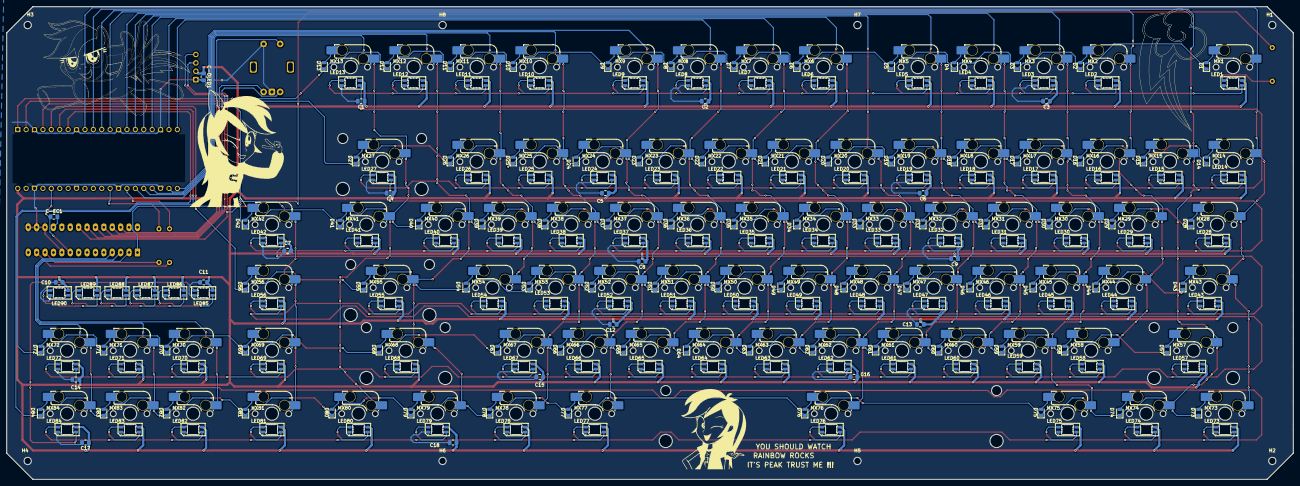
[picture p64: board RAINBOW DASH PCB.kicad_pcb from below]

Board: 2 copper layers, 388.9 x 142.9 mm, 298 parts (291 on the bottom side), 213 nets.
