Mattiplex/RAINBOW-DASH-Keyboard-/(commit log)

2026-09-29 Revise project timeline for PCB and case updates
    Updated project timeline with details on PCB design completion and case issues.
2026-10-14 Revise Project Timeline with daily updates
    Updated project timeline with detailed daily logs of progress and challenges faced during the keyboard design and PCB routing process.
2026-10-14 Revise Project Timeline with daily updates and images
    Updated project timeline with detailed progress and images for each day, including changes to schematics, wiring, and components used.
2026-10-15 Create photo folder pcb after redesign
2026-10-15 Create PCB 3D model
2026-10-15 Add initial content to PCB file
2026-10-15 Add 3D model to PCB FILE
2026-10-15 Create pcb ccc
2026-10-19 Remove video link from assembly section
    Removed video link for assembly section in README.
2026-10-20 Update pricing for aluminum plate and shipping fees
2026-10-20 Enhance README with project details and images
    Added sections about PCB and Case, including images and materials used. Updated learning experiences and project details.
